pe0mgb/SI4735-Radio-ESP32-Touchscreen-Arduino/SI4732_Radio_schematics.png

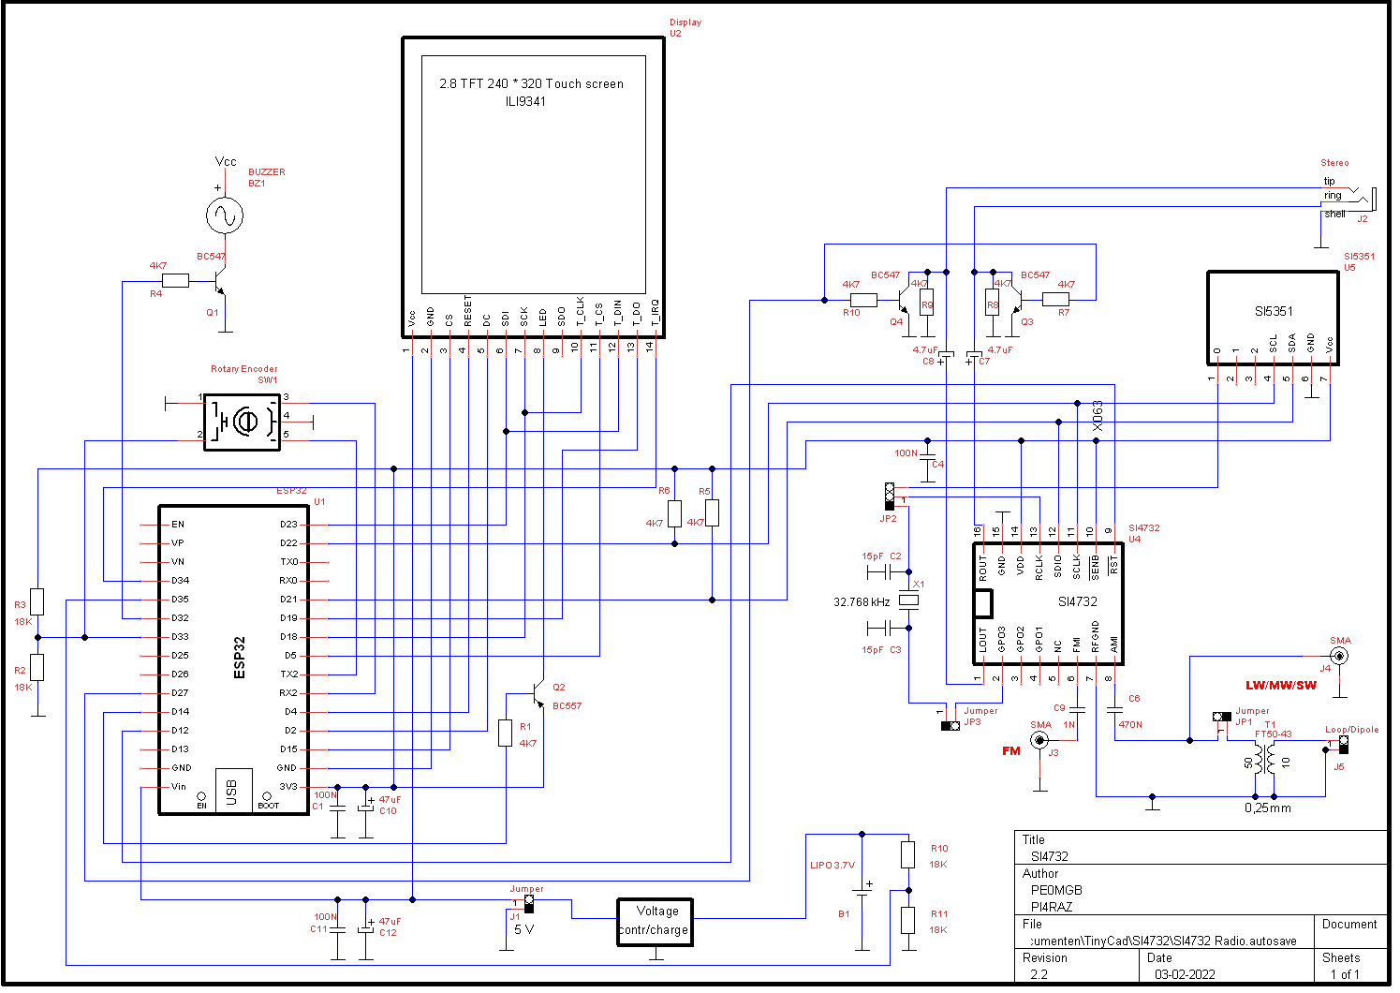
SI4732_Radio_schematics.png
