pe0mgb/SI4735-Radio-ESP32-Touchscreen-Arduino/SI4735 Radio.Receiver.png

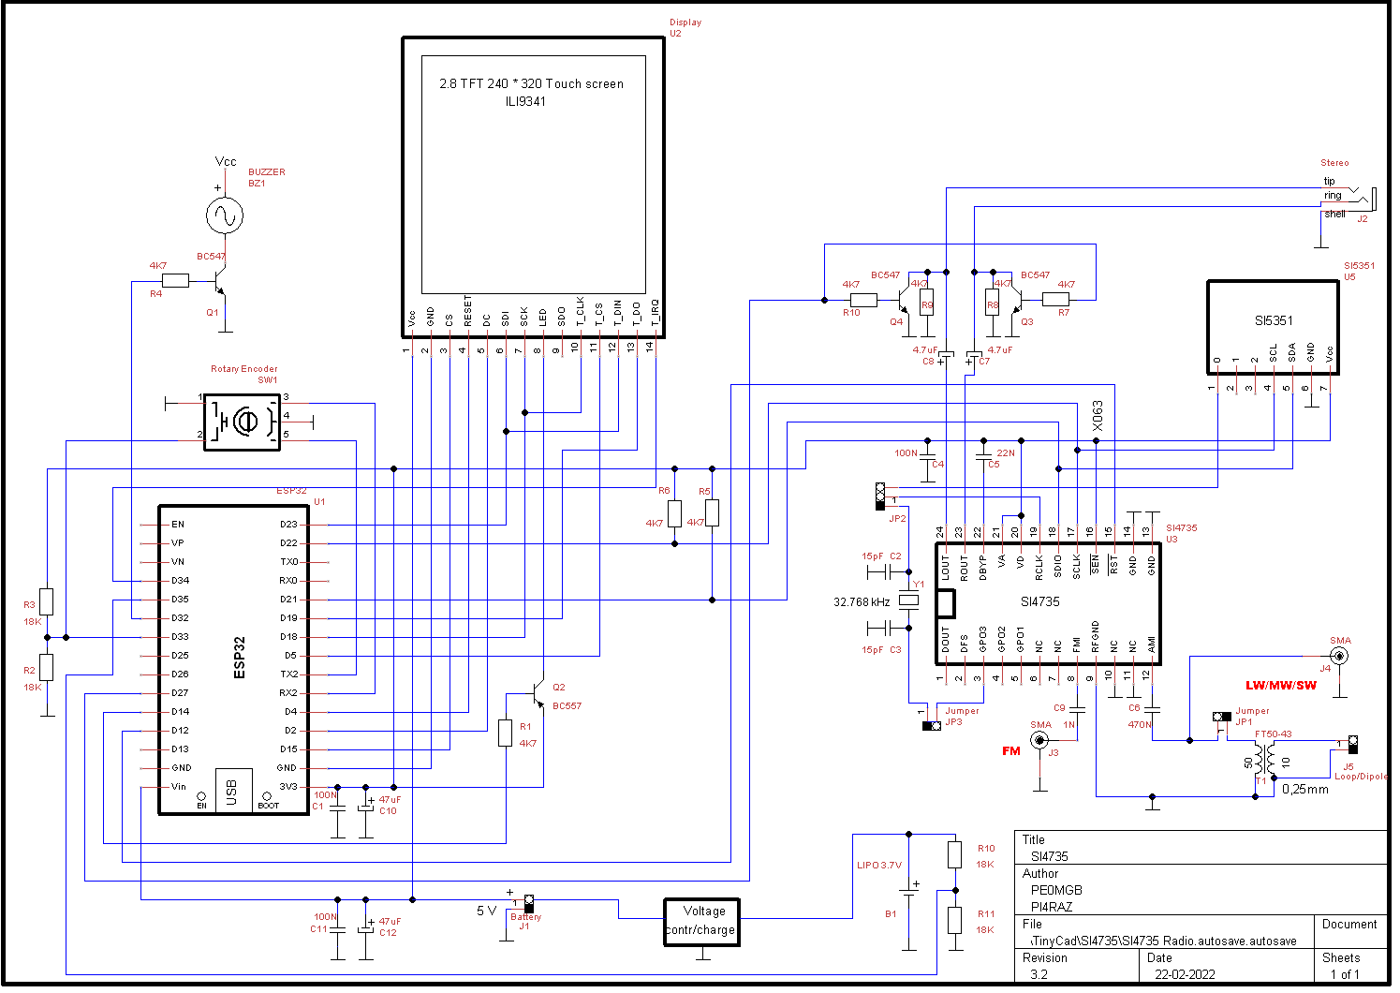
SI4735 Radio.Receiver.png
