pe0mgb/SI4735-Radio-ESP32-Touchscreen-Arduino/(threads)

Thread 1 (2020-05-28):

error

platone58, 2020-05-28:
can you help me?
i have a error compiling . this
'class SI4735' has no member named 'seekStationProgress'
but i have set libraryes and also all dependancies

pe0mgb, 2020-05-29:
Hello, I have compiled the sketch with the latest version of the library , downloaded from de si4735 github from PU2CLR Ricardo. I did not find any problem. Compilation and linking ran 100% OK. So check you library. Do have maybe the library installed twice?

Regards,

Gert PE0MGB

Van: platone58 [mailto:notifications@github.com]
Verzonden: donderdag 28 mei 2020 22:22
Aan: pe0mgb/SI4735-Radio-ESP32-Touchscreen-Arduino
CC: Subscribed
Onderwerp: [pe0mgb/SI4735-Radio-ESP32-Touchscreen-Arduino] error (#1)

can you help me?
i have a error compiling . this
'class SI4735' has no member named 'seekStationProgress'
but i have set libraryes and also all dependancies

—
You are receiving this because you are subscribed to this thread.
Reply to this email directly, view it on GitHub <https://github.com/pe0mgb/SI4735-Radio-ESP32-Touchscreen-Arduino/issues/1> , or unsubscribe <https://github.com/notifications/unsubscribe-auth/AEVBG5MHVDXWQIAYNUTA5GLRT3BXZANCNFSM4NNMX4JQ> .Afbeelding verwijderd door afzender.

--
Dit e-mailbericht is gecontroleerd op virussen met Avast antivirussoftware.
https://www.avast.com/antivirus

platone58, 2020-05-29:
I deleted and reinstalled the last library for Si4735 and the error is gone
but now I have this error:
exit status 1
Error compiling for board ESP32 Dev Module. I think my ESP32 library is not
good, which library did you use? thanks Giovanni from Italy

Il giorno ven 29 mag 2020 alle ore 12:27 Gert PE0MGB <
notifications@github.com> ha scritto:

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

platone58, 2020-05-29:
thanks , i have deleted all library and reinstalled , now work whitout error

Closed 2020-05-29.

Thread 2 (2020-05-31):

When I compile the sketch I receive error

Snowist, 2020-05-31:
I think following function needs definition before called
--------------------------------------------------------------------------------

si4735_2.8_TFT:717:16: error: expected initializer before 'RotaryEncFreq'

 void IRAM_ATTR RotaryEncFreq()

Snowist, 2020-05-31:
Solved. Wrong board selected. Currently selected ESP32 Dev board. However new compile error appeared. I have deleted other encode libraries, but this error still persist.

C:\Users\snowb\Documents\Arduino\Projeler\SI4735-Radio-ESP32-Touchscreen-Arduino-master\si4735_2.8_TFT\si4735_2.8_TFT.ino: In function 'void setup()':

si4735_2.8_TFT:779:57: error: 'RotaryEncFreq' was not declared in this scope

   attachInterrupt(digitalPinToInterrupt(ENCODER_PIN_A), RotaryEncFreq, CHANGE);

pe0mgb, 2020-05-31:
Must be wrong library. Use the supplied encoder library.

Outlook voor Android downloaden

On Sun, May 31, 2020 at 6:49 PM +0200, "Snowist" <notifications@github.com> wrote:

Solved. Wrong board selected. Currently selected ESP32 Dev board. However new compile error appeared. I have deleted other encode libraries, but this error still persist.

C:\Users\snowb\Documents\Arduino\Projeler\SI4735-Radio-ESP32-Touchscreen-Arduino-master\si4735_2.8_TFT\si4735_2.8_TFT.ino: In function 'void setup()':

si4735_2.8_TFT:779:57: error: 'RotaryEncFreq' was not declared in this scope

attachInterrupt(digitalPinToInterrupt(ENCODER_PIN_A), RotaryEncFreq, CHANGE);

—
You are receiving this because you are subscribed to this thread.
Reply to this email directly, view it on GitHub, or unsubscribe.

Snowist, 2020-06-01:
There is no other Rotary library. Just  PU2CLR_SI4735 and TFT_eSPI libs. Also tried this in VS Code Platform Tools and same error happened.

Snowist, 2020-06-01:
Found missing declaration of "RotaryEncFreq" in code and addded and created pull request.

Snowist, 2020-06-01:
I tried to add following code in my in, but just realized it is already available in .ino file here. I didn't understand why my download is missing this part of code. When I add this code worked fine.

//=======================================================================================
void IRAM_ATTR RotaryEncFreq()
//=======================================================================================
{
  // rotary encoder events
  if (!writingEeprom){
    encoderStatus = encoder.process();

    if (encoderStatus)
    {
      if (encoderStatus == DIR_CW)// Direction clockwise
      {
        encoderCount = 1;
      }
      else
      {
        encoderCount = -1;
      }
    }
  }
}

Closed 2020-06-01.

Thread 4 (2020-11-17):

HEX for ESP32 upload

Dfinitski, 2020-11-17:
Hi. I am not able to compile this project. Where can I find ready to upload HEX file ?
It would be perfect keep releases here.

pe0mgb, 2020-11-17:
David,Sorry, I have no idea how to make a hex file for the ESP32. I will try to figure it  out.Also to upload I have to check.Regards Gert PE0MGBVerzonden vanaf Samsung-tablet.
-------- Oorspronkelijk bericht --------Van: David Fainitski <notifications@github.com> Datum: 17-11-20  22:41  (GMT+01:00) Aan: pe0mgb/SI4735-Radio-ESP32-Touchscreen-Arduino <SI4735-Radio-ESP32-Touchscreen-Arduino@noreply.github.com> Cc: Subscribed <subscribed@noreply.github.com> Onderwerp: [pe0mgb/SI4735-Radio-ESP32-Touchscreen-Arduino] HEX for ESP32 upload (#4)
Hi. I am not able to compile this project. Where can I find ready to upload HEX file ?
It would be perfect keep releases here.

—You are receiving this because you are subscribed to this thread.Reply to this email directly, view it on GitHub, or unsubscribe.
[
{
"@context": "http://schema.org",
"@type": "EmailMessage",
"potentialAction": {
"@type": "ViewAction",
"target": "https://github.com/pe0mgb/SI4735-Radio-ESP32-Touchscreen-Arduino/issues/4",
"url": "https://github.com/pe0mgb/SI4735-Radio-ESP32-Touchscreen-Arduino/issues/4",
"name": "View Issue"
},
"description": "View this Issue on GitHub",
"publisher": {
"@type": "Organization",
"name": "GitHub",
"url": "https://github.com"
}
}
]

Dfinitski, 2020-11-17:
Hi. Try Sketch -> Export compiled binary

leogoto, 2020-11-17:
Hi David,

Here is hex file.

Leo/WH2Q

On Tue, 17 Nov 2020 15:36:12 -0800
David Fainitski <notifications@github.com> wrote:

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

--
Leo Gotoh <LeoGoto@yahoo.co.jp>
http://travelx.org

Dfinitski, 2020-11-18:
Hi, Leo.
Where is exactly ? Please give a link.

leogoto, 2020-11-18:
Hi David,

I do compiling.

On Tue, 17 Nov 2020 19:12:07 -0800
David Fainitski <notifications@github.com> wrote:

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

--
Leo Gotoh <LeoGoto@yahoo.co.jp>
http://travelx.org

Dfinitski, 2020-11-18:
Yes, "Export compiled binary" option creates bin file in the same directory where placed ino file.
Later everyone could upload that file into ESP32 without compilation of the project.
Sorry, initially I thought hex files format is working binary file for Arduino.
No, bin file of course.

Closed 2020-11-20.

Thread 5 (2020-11-18):

Compilation error

Dfinitski, 2020-11-18:
Hi.
I just installed latest TFT_eSPI-master and SI4735-master,

C:\SI4735-Radio-ESP32-Touchscreen-Arduino-master\si4735_2.8_TFT\si4735_2.8_TFT.ino: In function 'void setup()':
si4735_2.8_TFT:769:9: error: 'class TFT_eSPI' has no member named 'setTouch'
     tft.setTouch(calData);
         ^
C:\SI4735-Radio-ESP32-Touchscreen-Arduino-master\si4735_2.8_TFT\si4735_2.8_TFT.ino: In function 'void loop()':
si4735_2.8_TFT:1103:19: error: 'class TFT_eSPI' has no member named 'getTouch'
     pressed = tft.getTouch(&x, &y);
                   ^
C:\SI4735-Radio-ESP32-Touchscreen-Arduino-master\si4735_2.8_TFT\si4735_2.8_TFT.ino: In function 'void subrstatus()':
si4735_2.8_TFT:2296:18: error: 'class TFT_eSPI' has no member named 'getTouch'
     press1 = tft.getTouch(&x, &y);
                  ^
exit status 1
'class TFT_eSPI' has no member named 'setTouch'

pe0mgb, 2020-11-18:
Read my github , how to use tft_espiVerzonden vanaf Samsung-tablet.
-------- Oorspronkelijk bericht --------Van: David Fainitski <notifications@github.com> Datum: 18-11-20  04:38  (GMT+01:00) Aan: pe0mgb/SI4735-Radio-ESP32-Touchscreen-Arduino <SI4735-Radio-ESP32-Touchscreen-Arduino@noreply.github.com> Cc: Subscribed <subscribed@noreply.github.com> Onderwerp: [pe0mgb/SI4735-Radio-ESP32-Touchscreen-Arduino] Compilation error (#5)
Hi.
I just installed latest TFT_eSPI-master and SI4735-master,
C:\SI4735-Radio-ESP32-Touchscreen-Arduino-master\si4735_2.8_TFT\si4735_2.8_TFT.ino: In function 'void setup()':
si4735_2.8_TFT:769:9: error: 'class TFT_eSPI' has no member named 'setTouch'
tft.setTouch(calData);
^
C:\SI4735-Radio-ESP32-Touchscreen-Arduino-master\si4735_2.8_TFT\si4735_2.8_TFT.ino: In function 'void loop()':
si4735_2.8_TFT:1103:19: error: 'class TFT_eSPI' has no member named 'getTouch'
pressed = tft.getTouch(&x, &y);
^
C:\SI4735-Radio-ESP32-Touchscreen-Arduino-master\si4735_2.8_TFT\si4735_2.8_TFT.ino: In function 'void subrstatus()':
si4735_2.8_TFT:2296:18: error: 'class TFT_eSPI' has no member named 'getTouch'
press1 = tft.getTouch(&x, &y);
^
exit status 1
'class TFT_eSPI' has no member named 'setTouch'

—You are receiving this because you are subscribed to this thread.Reply to this email directly, view it on GitHub, or unsubscribe.
[
{
"@context": "http://schema.org",
"@type": "EmailMessage",
"potentialAction": {
"@type": "ViewAction",
"target": "https://github.com/pe0mgb/SI4735-Radio-ESP32-Touchscreen-Arduino/issues/5",
"url": "https://github.com/pe0mgb/SI4735-Radio-ESP32-Touchscreen-Arduino/issues/5",
"name": "View Issue"
},
"description": "View this Issue on GitHub",
"publisher": {
"@type": "Organization",
"name": "GitHub",
"url": "https://github.com"
}
}
]

Dfinitski, 2020-11-18:
Thanks for the update.
Now compilation is successful.

Closed 2020-11-18.

Thread 6 (2021-01-03):

2.8" TFT SPI 240*320

Haranochi, 2021-01-03:
I have finished building your project and it works correctly, the problem I have is that the touch screen does not work, I use a Chinese display with reference KMRTM28028-SPI, (ILI9341), I cannot find your data sheet on the Internet, can you help me to solve the problem. Thank you.

https://user-images.githubusercontent.com/76921787/103490211-8a386500-4e1a-11eb-8871-fd9760534a44.MOV

pe0mgb, 2021-01-03:
I'm afraid it is not a touchscreen. Please send me a picture of the backsite.Verzonden vanaf Samsung-tablet.
-------- Oorspronkelijk bericht --------Van: Haranochi <notifications@github.com> Datum: 03-01-21  23:22  (GMT+01:00) Aan: pe0mgb/SI4735-Radio-ESP32-Touchscreen-Arduino <SI4735-Radio-ESP32-Touchscreen-Arduino@noreply.github.com> Cc: Subscribed <subscribed@noreply.github.com> Onderwerp: [pe0mgb/SI4735-Radio-ESP32-Touchscreen-Arduino] 2.8" TFT SPI 240*320 (#6)
I have finished building your project and it works correctly, the problem I have is that the touch screen does not work, I use a Chinese display with reference KMRTM28028-SPI, (ILI9341), I cannot find your data sheet on the Internet, can you help me to solve the problem. Thank you.
https://user-images.githubusercontent.com/76921787/103490211-8a386500-4e1a-11eb-8871-fd9760534a44.MOV

—You are receiving this because you are subscribed to this thread.Reply to this email directly, view it on GitHub, or unsubscribe.
[
{
"@context": "http://schema.org",
"@type": "EmailMessage",
"potentialAction": {
"@type": "ViewAction",
"target": "https://github.com/pe0mgb/SI4735-Radio-ESP32-Touchscreen-Arduino/issues/6",
"url": "https://github.com/pe0mgb/SI4735-Radio-ESP32-Touchscreen-Arduino/issues/6",
"name": "View Issue"
},
"description": "View this Issue on GitHub",
"publisher": {
"@type": "Organization",
"name": "GitHub",
"url": "https://github.com"
}
}
]

Haranochi, 2021-01-04:
Thanks for your answer, I attach an image of the back of the display, you will see that it has an IC (HR2046), I suppose a clone of the XPT2046, ¿maybe it be defective?
In the preamble of your sketch it indicates that the display is powered by 3V3, but in your scheme the VCC of the display indicates 5V, of course it can be powered by 3V3 or 5V, your display with what voltage is it powered, in my construction I feed it with 5V If I had to feed it to 3V3, I would have to make a jumper on J1 of the display and change the supply on the pcb to 3V3. I see in the file Setup1_ILI93441.h the clock frequency of the XPT2046 is 25MHz, can it be modified to a value of 20MHz ?. The balun you use what type of copper wire you use. Thank you for your response and for making your project available to millions of people.
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

pe0mgb, 2021-01-04:
Hello Haranochi.

Thanks for the picture. What I have found on the internet that the chips are the same. Same functionality. An other story was that from your displays touch screen has different dimensions and is reverse mounted. I can not check all this information. We all know that there enough nonsense available on the Web.

Anyway I don’t know but also the layout of the TFT pcb is different as mine.  I was even not aware that other different version of the display exist.

 <https://a.aliexpress.com/_B1zwoE> https://a.aliexpress.com/_B1zwoE

This is where I have ordered my displays and a lot of other people did. Order the 2.8 TFT SPI with touch 240*320. This is with the ILI9341 and the XPT2046.

I have V1.2. Hope this will solve your problem. This Aliexpress supplier is normally very fast. !0 days here in the Netherlands.

Thanks for your remark about the 3.3 v and 5v supply of the display. I think it is better to use the 5v for the display. Then the regulator at the display is now making the 3.3v and is generating some heath .

When you supply it with 3.3v (J1)  then the esp32 regulator has to do all the work. I prefer the first proposal. I’m using 5v.

Your 25MHz or 20 MHz I don’t know how it’s working, just try it.

I’m not sure about your balun question. Are you talking about the transformer with 50 and 10 turns?. Well with the FT50-43 I use 0,2 mm or 0,25 mm. 0.3 is possible but then you may have a some spacing problem.

Best Regards,

Gert PE0MGB

Van: Haranochi [mailto:notifications@github.com]
Verzonden: maandag 4 januari 2021 12:57
Aan: pe0mgb/SI4735-Radio-ESP32-Touchscreen-Arduino
CC: Gert PE0MGB; Comment
Onderwerp: Re: [pe0mgb/SI4735-Radio-ESP32-Touchscreen-Arduino] 2.8" TFT SPI 240*320 (#6)

Thanks for your answer, I attach an image of the back of the display, you will see that it has an IC (HR2046), I suppose a clone of the XPT2046, ¿maybe it be defective?
In the preamble of your sketch it indicates that the display is powered by 3V3, but in your scheme the VCC of the display indicates 5V, of course it can be powered by 3V3 or 5V, your display with what voltage is it powered, in my construction I feed it with 5V If I had to feed it to 3V3, I would have to make a jumper on J1 of the display and change the supply on the pcb to 3V3. I see in the file Setup1_ILI93441.h the clock frequency of the XPT2046 is 25MHz, can it be modified to a value of 20MHz ?. The balun you use what type of copper wire you use. Thank you for your response and for making your project available to millions of people.
 <https://user-images.githubusercontent.com/76921787/103532779-23539400-4e8c-11eb-91e4-979a438f5ba2.jpg> Afbeelding verwijderd door afzender. IMG-4069

—
You are receiving this because you commented.
Reply to this email directly, view it on GitHub <https://github.com/pe0mgb/SI4735-Radio-ESP32-Touchscreen-Arduino/issues/6#issuecomment-753934497> , or unsubscribe <https://github.com/notifications/unsubscribe-auth/AEVBG5NNFZDK4MUKP6ANJ7DSYGUJVANCNFSM4VSHA7HA> .Afbeelding verwijderd door afzender.

--
Dit e-mailbericht is gecontroleerd op virussen met Avast antivirussoftware.
https://www.avast.com/antivirus

Haranochi, 2021-01-04:
Hi Gert,

Thanks again, another question in the Setup1_ILI9341.h file, has the following definition;

// For ESP32 Dev board (only tested with ILI9341 display)

// The hardware SPI can be mapped to any pins

#define TFT_MISO 19

#define TFT_MOSI 23

#define TFT_SCLK 18

#define TFT_CS 15 // Chip select control pin

#define TFT_DC 2 // Data Command control pin

#define TFT_RST 4 // Reset pin (could connect to RST pin)

#define TOUCH_CS 5 // Chip select pin (T_CS) of touch screen

#define TFT_MISO 19, does not connect, but Touch_DO (SPI bus out) also uses pin 19, are there problems with this configuration?

Best Regards

José María

De: Gert PE0MGB <notifications@github.com>
Enviado el: lunes, 04 de enero de 2021 15:48
Para: pe0mgb/SI4735-Radio-ESP32-Touchscreen-Arduino <SI4735-Radio-ESP32-Touchscreen-Arduino@noreply.github.com>
CC: Haranochi <haranochi@telefonica.net>; Author <author@noreply.github.com>
Asunto: Re: [pe0mgb/SI4735-Radio-ESP32-Touchscreen-Arduino] 2.8" TFT SPI 240*320 (#6)

Hello Haranochi.

Thanks for the picture. What I have found on the internet that the chips are the same. Same functionality. An other story was that from your displays touch screen has different dimensions and is reverse mounted. I can not check all this information. We all know that there enough nonsense available on the Web.

Anyway I don’t know but also the layout of the TFT pcb is different as mine. I was even not aware that other different version of the display exist.

<https://a.aliexpress.com/_B1zwoE> https://a.aliexpress.com/_B1zwoE

This is where I have ordered my displays and a lot of other people did. Order the 2.8 TFT SPI with touch 240*320. This is with the ILI9341 and the XPT2046.

I have V1.2. Hope this will solve your problem. This Aliexpress supplier is normally very fast. !0 days here in the Netherlands.

Thanks for your remark about the 3.3 v and 5v supply of the display. I think it is better to use the 5v for the display. Then the regulator at the display is now making the 3.3v and is generating some heath .

When you supply it with 3.3v (J1) then the esp32 regulator has to do all the work. I prefer the first proposal. I’m using 5v.

Your 25MHz or 20 MHz I don’t know how it’s working, just try it.

I’m not sure about your balun question. Are you talking about the transformer with 50 and 10 turns?. Well with the FT50-43 I use 0,2 mm or 0,25 mm. 0.3 is possible but then you may have a some spacing problem.

Best Regards,

Gert PE0MGB

Van: Haranochi [mailto:notifications@github.com]
Verzonden: maandag 4 januari 2021 12:57
Aan: pe0mgb/SI4735-Radio-ESP32-Touchscreen-Arduino
CC: Gert PE0MGB; Comment
Onderwerp: Re: [pe0mgb/SI4735-Radio-ESP32-Touchscreen-Arduino] 2.8" TFT SPI 240*320 (#6)

Thanks for your answer, I attach an image of the back of the display, you will see that it has an IC (HR2046), I suppose a clone of the XPT2046, ¿maybe it be defective?
In the preamble of your sketch it indicates that the display is powered by 3V3, but in your scheme the VCC of the display indicates 5V, of course it can be powered by 3V3 or 5V, your display with what voltage is it powered, in my construction I feed it with 5V If I had to feed it to 3V3, I would have to make a jumper on J1 of the display and change the supply on the pcb to 3V3. I see in the file Setup1_ILI93441.h the clock frequency of the XPT2046 is 25MHz, can it be modified to a value of 20MHz ?. The balun you use what type of copper wire you use. Thank you for your response and for making your project available to millions of people.
<https://user-images.githubusercontent.com/76921787/103532779-23539400-4e8c-11eb-91e4-979a438f5ba2.jpg> Afbeelding verwijderd door afzender. IMG-4069

—
You are receiving this because you commented.
Reply to this email directly, view it on GitHub <https://github.com/pe0mgb/SI4735-Radio-ESP32-Touchscreen-Arduino/issues/6#issuecomment-753934497> , or unsubscribe <https://github.com/notifications/unsubscribe-auth/AEVBG5NNFZDK4MUKP6ANJ7DSYGUJVANCNFSM4VSHA7HA> .Afbeelding verwijderd door afzender.

--
Dit e-mailbericht is gecontroleerd op virussen met Avast antivirussoftware.
https://www.avast.com/antivirus

—
You are receiving this because you authored the thread.
Reply to this email directly, view it on GitHub <https://github.com/pe0mgb/SI4735-Radio-ESP32-Touchscreen-Arduino/issues/6#issuecomment-754017494> , or unsubscribe <https://github.com/notifications/unsubscribe-auth/ASK3XOZKWIUWJDBJKVIM2TTSYHILFANCNFSM4VSHA7HA> .

pe0mgb, 2021-01-04:
Hello José,

Good question about D19. Pin9 or SDO is the data-out of the TFT and has to be used if you want to make a dump of a certain screen.. To save pins some screen and touch pins are connected in parallel.

The selection is done with CS (chip select) pin 3 for the TFT and T_CS (pin 11) for the touch screen. Everything is working fine with the SDO(pin9) and T_DO(pin13) in parallel. I’m also working at a 3.5 inch display that you can control  with the same hardware configuration. However the SDO (pin9) at 3.5 TFT is not tri-state. and keep pin 13(T_DO) fixed and the touch is not working. Because SDO (pin9) is not used in our application I do not connect it anymore.  Now the 2.8 and 3.5 inch TFT display are working in the same hardware configuration and can be interchanged. Be care full you still need dedicated software to control the different displays. Hope this answered your question. I’m sure this has nothing to do with your problem.

Regards,

Gert PE0MGB

Van: Haranochi [mailto:notifications@github.com]
Verzonden: maandag 4 januari 2021 18:24
Aan: pe0mgb/SI4735-Radio-ESP32-Touchscreen-Arduino
CC: Gert PE0MGB; Comment
Onderwerp: Re: [pe0mgb/SI4735-Radio-ESP32-Touchscreen-Arduino] 2.8" TFT SPI 240*320 (#6)

Hi Gert,

Thanks again, another question in the Setup1_ILI9341.h file, has the following definition;

// For ESP32 Dev board (only tested with ILI9341 display)

// The hardware SPI can be mapped to any pins

#define TFT_MISO 19

#define TFT_MOSI 23

#define TFT_SCLK 18

#define TFT_CS 15 // Chip select control pin

#define TFT_DC 2 // Data Command control pin

#define TFT_RST 4 // Reset pin (could connect to RST pin)

#define TOUCH_CS 5 // Chip select pin (T_CS) of touch screen

#define TFT_MISO 19, does not connect, but Touch_DO (SPI bus out) also uses pin 19, are there problems with this configuration?

Best Regards

José María

De: Gert PE0MGB <notifications@github.com>
Enviado el: lunes, 04 de enero de 2021 15:48
Para: pe0mgb/SI4735-Radio-ESP32-Touchscreen-Arduino <SI4735-Radio-ESP32-Touchscreen-Arduino@noreply.github.com>
CC: Haranochi <haranochi@telefonica.net>; Author <author@noreply.github.com>
Asunto: Re: [pe0mgb/SI4735-Radio-ESP32-Touchscreen-Arduino] 2.8" TFT SPI 240*320 (#6)

Hello Haranochi.

Thanks for the picture. What I have found on the internet that the chips are the same. Same functionality. An other story was that from your displays touch screen has different dimensions and is reverse mounted. I can not check all this information. We all know that there enough nonsense available on the Web.

Anyway I don’t know but also the layout of the TFT pcb is different as mine. I was even not aware that other different version of the display exist.

<https://a.aliexpress.com/_B1zwoE> https://a.aliexpress.com/_B1zwoE

This is where I have ordered my displays and a lot of other people did. Order the 2.8 TFT SPI with touch 240*320. This is with the ILI9341 and the XPT2046.

I have V1.2. Hope this will solve your problem. This Aliexpress supplier is normally very fast. !0 days here in the Netherlands.

Thanks for your remark about the 3.3 v and 5v supply of the display. I think it is better to use the 5v for the display. Then the regulator at the display is now making the 3.3v and is generating some heath .

When you supply it with 3.3v (J1) then the esp32 regulator has to do all the work. I prefer the first proposal. I’m using 5v.

Your 25MHz or 20 MHz I don’t know how it’s working, just try it.

I’m not sure about your balun question. Are you talking about the transformer with 50 and 10 turns?. Well with the FT50-43 I use 0,2 mm or 0,25 mm. 0.3 is possible but then you may have a some spacing problem.

Best Regards,

Gert PE0MGB

Van: Haranochi [mailto:notifications@github.com]
Verzonden: maandag 4 januari 2021 12:57
Aan: pe0mgb/SI4735-Radio-ESP32-Touchscreen-Arduino
CC: Gert PE0MGB; Comment
Onderwerp: Re: [pe0mgb/SI4735-Radio-ESP32-Touchscreen-Arduino] 2.8" TFT SPI 240*320 (#6)

Thanks for your answer, I attach an image of the back of the display, you will see that it has an IC (HR2046), I suppose a clone of the XPT2046, ¿maybe it be defective?
In the preamble of your sketch it indicates that the display is powered by 3V3, but in your scheme the VCC of the display indicates 5V, of course it can be powered by 3V3 or 5V, your display with what voltage is it powered, in my construction I feed it with 5V If I had to feed it to 3V3, I would have to make a jumper on J1 of the display and change the supply on the pcb to 3V3. I see in the file Setup1_ILI93441.h the clock frequency of the XPT2046 is 25MHz, can it be modified to a value of 20MHz ?. The balun you use what type of copper wire you use. Thank you for your response and for making your project available to millions of people.
<https://user-images.githubusercontent.com/76921787/103532779-23539400-4e8c-11eb-91e4-979a438f5ba2.jpg> Afbeelding verwijderd door afzender. IMG-4069

—
You are receiving this because you commented.
Reply to this email directly, view it on GitHub <https://github.com/pe0mgb/SI4735-Radio-ESP32-Touchscreen-Arduino/issues/6#issuecomment-753934497> , or unsubscribe <https://github.com/notifications/unsubscribe-auth/AEVBG5NNFZDK4MUKP6ANJ7DSYGUJVANCNFSM4VSHA7HA> .Afbeelding verwijderd door afzender.

--
Dit e-mailbericht is gecontroleerd op virussen met Avast antivirussoftware.
https://www.avast.com/antivirus

—
You are receiving this because you authored the thread.
Reply to this email directly, view it on GitHub <https://github.com/pe0mgb/SI4735-Radio-ESP32-Touchscreen-Arduino/issues/6#issuecomment-754017494> , or unsubscribe <https://github.com/notifications/unsubscribe-auth/ASK3XOZKWIUWJDBJKVIM2TTSYHILFANCNFSM4VSHA7HA> .

—
You are receiving this because you commented.
Reply to this email directly, view it on GitHub <https://github.com/pe0mgb/SI4735-Radio-ESP32-Touchscreen-Arduino/issues/6#issuecomment-754105907> , or unsubscribe <https://github.com/notifications/unsubscribe-auth/AEVBG5PGRCL7AFZBLNQCN73SYH2UVANCNFSM4VSHA7HA> .Afbeelding verwijderd door afzender.

Haranochi, 2021-01-04:
Gert, good night

No, it is not related to my problem, curiosity to know the use of D19, thanks for the explanation, researching I have seen that pin 14 (T_IRQ) is always at high level and when it touched any menu on the screen it falls to low, this is correct, it detects a pressed menu key, now my question is about pin 11 (T_CS), it is high or low, in my case it is always high, it does not change, and I think it must be low to enable chip select signal. If you have time, you can explain to me the operation of the T_IRQ and T_CS pins. The Chinese display works with the Touch_calibrate example from the TFT_eSPI library, connecting it as indicated by the creator of the library, bodmer.

Regards

José María

De: Gert PE0MGB <notifications@github.com>
Enviado el: lunes, 04 de enero de 2021 19:58
Para: pe0mgb/SI4735-Radio-ESP32-Touchscreen-Arduino <SI4735-Radio-ESP32-Touchscreen-Arduino@noreply.github.com>
CC: Haranochi <haranochi@telefonica.net>; Author <author@noreply.github.com>
Asunto: Re: [pe0mgb/SI4735-Radio-ESP32-Touchscreen-Arduino] 2.8" TFT SPI 240*320 (#6)

Hello José,

Good question about D19. Pin9 or SDO is the data-out of the TFT and has to be used if you want to make a dump of a certain screen.. To save pins some screen and touch pins are connected in parallel.

The selection is done with CS (chip select) pin 3 for the TFT and T_CS (pin 11) for the touch screen. Everything is working fine with the SDO(pin9) and T_DO(pin13) in parallel. I’m also working at a 3.5 inch display that you can control with the same hardware configuration. However the SDO (pin9) at 3.5 TFT is not tri-state. and keep pin 13(T_DO) fixed and the touch is not working. Because SDO (pin9) is not used in our application I do not connect it anymore. Now the 2.8 and 3.5 inch TFT display are working in the same hardware configuration and can be interchanged. Be care full you still need dedicated software to control the different displays. Hope this answered your question. I’m sure this has nothing to do with your problem.

Regards,

Gert PE0MGB

Van: Haranochi [mailto:notifications@github.com]
Verzonden: maandag 4 januari 2021 18:24
Aan: pe0mgb/SI4735-Radio-ESP32-Touchscreen-Arduino
CC: Gert PE0MGB; Comment
Onderwerp: Re: [pe0mgb/SI4735-Radio-ESP32-Touchscreen-Arduino] 2.8" TFT SPI 240*320 (#6)

Hi Gert,

Thanks again, another question in the Setup1_ILI9341.h file, has the following definition;

// For ESP32 Dev board (only tested with ILI9341 display)

// The hardware SPI can be mapped to any pins

#define TFT_MISO 19

#define TFT_MOSI 23

#define TFT_SCLK 18

#define TFT_CS 15 // Chip select control pin

#define TFT_DC 2 // Data Command control pin

#define TFT_RST 4 // Reset pin (could connect to RST pin)

#define TOUCH_CS 5 // Chip select pin (T_CS) of touch screen

#define TFT_MISO 19, does not connect, but Touch_DO (SPI bus out) also uses pin 19, are there problems with this configuration?

Best Regards

José María

De: Gert PE0MGB <notifications@github.com>
Enviado el: lunes, 04 de enero de 2021 15:48
Para: pe0mgb/SI4735-Radio-ESP32-Touchscreen-Arduino <SI4735-Radio-ESP32-Touchscreen-Arduino@noreply.github.com>
CC: Haranochi <haranochi@telefonica.net>; Author <author@noreply.github.com>
Asunto: Re: [pe0mgb/SI4735-Radio-ESP32-Touchscreen-Arduino] 2.8" TFT SPI 240*320 (#6)

Hello Haranochi.

Thanks for the picture. What I have found on the internet that the chips are the same. Same functionality. An other story was that from your displays touch screen has different dimensions and is reverse mounted. I can not check all this information. We all know that there enough nonsense available on the Web.

Anyway I don’t know but also the layout of the TFT pcb is different as mine. I was even not aware that other different version of the display exist.

<https://a.aliexpress.com/_B1zwoE> https://a.aliexpress.com/_B1zwoE

This is where I have ordered my displays and a lot of other people did. Order the 2.8 TFT SPI with touch 240*320. This is with the ILI9341 and the XPT2046.

I have V1.2. Hope this will solve your problem. This Aliexpress supplier is normally very fast. !0 days here in the Netherlands.

Thanks for your remark about the 3.3 v and 5v supply of the display. I think it is better to use the 5v for the display. Then the regulator at the display is now making the 3.3v and is generating some heath .

When you supply it with 3.3v (J1) then the esp32 regulator has to do all the work. I prefer the first proposal. I’m using 5v.

Your 25MHz or 20 MHz I don’t know how it’s working, just try it.

I’m not sure about your balun question. Are you talking about the transformer with 50 and 10 turns?. Well with the FT50-43 I use 0,2 mm or 0,25 mm. 0.3 is possible but then you may have a some spacing problem.

Best Regards,

Gert PE0MGB

Van: Haranochi [mailto:notifications@github.com]
Verzonden: maandag 4 januari 2021 12:57
Aan: pe0mgb/SI4735-Radio-ESP32-Touchscreen-Arduino
CC: Gert PE0MGB; Comment
Onderwerp: Re: [pe0mgb/SI4735-Radio-ESP32-Touchscreen-Arduino] 2.8" TFT SPI 240*320 (#6)

Thanks for your answer, I attach an image of the back of the display, you will see that it has an IC (HR2046), I suppose a clone of the XPT2046, ¿maybe it be defective?
In the preamble of your sketch it indicates that the display is powered by 3V3, but in your scheme the VCC of the display indicates 5V, of course it can be powered by 3V3 or 5V, your display with what voltage is it powered, in my construction I feed it with 5V If I had to feed it to 3V3, I would have to make a jumper on J1 of the display and change the supply on the pcb to 3V3. I see in the file Setup1_ILI93441.h the clock frequency of the XPT2046 is 25MHz, can it be modified to a value of 20MHz ?. The balun you use what type of copper wire you use. Thank you for your response and for making your project available to millions of people.
<https://user-images.githubusercontent.com/76921787/103532779-23539400-4e8c-11eb-91e4-979a438f5ba2.jpg> Afbeelding verwijderd door afzender. IMG-4069

—
You are receiving this because you commented.
Reply to this email directly, view it on GitHub <https://github.com/pe0mgb/SI4735-Radio-ESP32-Touchscreen-Arduino/issues/6#issuecomment-753934497> , or unsubscribe <https://github.com/notifications/unsubscribe-auth/AEVBG5NNFZDK4MUKP6ANJ7DSYGUJVANCNFSM4VSHA7HA> .Afbeelding verwijderd door afzender.

--
Dit e-mailbericht is gecontroleerd op virussen met Avast antivirussoftware.
https://www.avast.com/antivirus

—
You are receiving this because you authored the thread.
Reply to this email directly, view it on GitHub <https://github.com/pe0mgb/SI4735-Radio-ESP32-Touchscreen-Arduino/issues/6#issuecomment-754017494> , or unsubscribe <https://github.com/notifications/unsubscribe-auth/ASK3XOZKWIUWJDBJKVIM2TTSYHILFANCNFSM4VSHA7HA> .

—
You are receiving this because you commented.
Reply to this email directly, view it on GitHub <https://github.com/pe0mgb/SI4735-Radio-ESP32-Touchscreen-Arduino/issues/6#issuecomment-754105907> , or unsubscribe <https://github.com/notifications/unsubscribe-auth/AEVBG5PGRCL7AFZBLNQCN73SYH2UVANCNFSM4VSHA7HA> .Afbeelding verwijderd door afzender.

—
You are receiving this because you authored the thread.
Reply to this email directly, view it on GitHub <https://github.com/pe0mgb/SI4735-Radio-ESP32-Touchscreen-Arduino/issues/6#issuecomment-754153841> , or unsubscribe <https://github.com/notifications/unsubscribe-auth/ASK3XO3POANDOB2NCH6FT33SYIFUNANCNFSM4VSHA7HA> .

pe0mgb, 2021-01-05:
José,

I understand that the calibration program is running and you can calibrate the TFT. That means that everything works. You can run the program on the radio without any change in files. Just download the calibration-program. Don’t forget the rotation. When the program works try to replace the calibration data in my program with the generated data by yourself. You can find this information at the beginning of the setup routine. When the program is not working, please check the display wiring.

Please let me know about the results.

Gert

Van: Haranochi [mailto:notifications@github.com]
Verzonden: maandag 4 januari 2021 22:49
Aan: pe0mgb/SI4735-Radio-ESP32-Touchscreen-Arduino
CC: Gert PE0MGB; Comment
Onderwerp: Re: [pe0mgb/SI4735-Radio-ESP32-Touchscreen-Arduino] 2.8" TFT SPI 240*320 (#6)

Gert, good night

No, it is not related to my problem, curiosity to know the use of D19, thanks for the explanation, researching I have seen that pin 14 (T_IRQ) is always at high level and when it touched any menu on the screen it falls to low, this is correct, it detects a pressed menu key, now my question is about pin 11 (T_CS), it is high or low, in my case it is always high, it does not change, and I think it must be low to enable chip select signal. If you have time, you can explain to me the operation of the T_IRQ and T_CS pins. The Chinese display works with the Touch_calibrate example from the TFT_eSPI library, connecting it as indicated by the creator of the library, bodmer.

Regards

José María

De: Gert PE0MGB <notifications@github.com>
Enviado el: lunes, 04 de enero de 2021 19:58
Para: pe0mgb/SI4735-Radio-ESP32-Touchscreen-Arduino <SI4735-Radio-ESP32-Touchscreen-Arduino@noreply.github.com>
CC: Haranochi <haranochi@telefonica.net>; Author <author@noreply.github.com>
Asunto: Re: [pe0mgb/SI4735-Radio-ESP32-Touchscreen-Arduino] 2.8" TFT SPI 240*320 (#6)

Hello José,

Good question about D19. Pin9 or SDO is the data-out of the TFT and has to be used if you want to make a dump of a certain screen.. To save pins some screen and touch pins are connected in parallel.

The selection is done with CS (chip select) pin 3 for the TFT and T_CS (pin 11) for the touch screen. Everything is working fine with the SDO(pin9) and T_DO(pin13) in parallel. I’m also working at a 3.5 inch display that you can control with the same hardware configuration. However the SDO (pin9) at 3.5 TFT is not tri-state. and keep pin 13(T_DO) fixed and the touch is not working. Because SDO (pin9) is not used in our application I do not connect it anymore. Now the 2.8 and 3.5 inch TFT display are working in the same hardware configuration and can be interchanged. Be care full you still need dedicated software to control the different displays. Hope this answered your question. I’m sure this has nothing to do with your problem.

Regards,

Gert PE0MGB

Van: Haranochi [mailto:notifications@github.com]
Verzonden: maandag 4 januari 2021 18:24
Aan: pe0mgb/SI4735-Radio-ESP32-Touchscreen-Arduino
CC: Gert PE0MGB; Comment
Onderwerp: Re: [pe0mgb/SI4735-Radio-ESP32-Touchscreen-Arduino] 2.8" TFT SPI 240*320 (#6)

Hi Gert,

Thanks again, another question in the Setup1_ILI9341.h file, has the following definition;

// For ESP32 Dev board (only tested with ILI9341 display)

// The hardware SPI can be mapped to any pins

#define TFT_MISO 19

#define TFT_MOSI 23

#define TFT_SCLK 18

#define TFT_CS 15 // Chip select control pin

#define TFT_DC 2 // Data Command control pin

#define TFT_RST 4 // Reset pin (could connect to RST pin)

#define TOUCH_CS 5 // Chip select pin (T_CS) of touch screen

#define TFT_MISO 19, does not connect, but Touch_DO (SPI bus out) also uses pin 19, are there problems with this configuration?

Best Regards

José María

De: Gert PE0MGB <notifications@github.com>
Enviado el: lunes, 04 de enero de 2021 15:48
Para: pe0mgb/SI4735-Radio-ESP32-Touchscreen-Arduino <SI4735-Radio-ESP32-Touchscreen-Arduino@noreply.github.com>
CC: Haranochi <haranochi@telefonica.net>; Author <author@noreply.github.com>
Asunto: Re: [pe0mgb/SI4735-Radio-ESP32-Touchscreen-Arduino] 2.8" TFT SPI 240*320 (#6)

Hello Haranochi.

Thanks for the picture. What I have found on the internet that the chips are the same. Same functionality. An other story was that from your displays touch screen has different dimensions and is reverse mounted. I can not check all this information. We all know that there enough nonsense available on the Web.

Anyway I don’t know but also the layout of the TFT pcb is different as mine. I was even not aware that other different version of the display exist.

<https://a.aliexpress.com/_B1zwoE> https://a.aliexpress.com/_B1zwoE

This is where I have ordered my displays and a lot of other people did. Order the 2.8 TFT SPI with touch 240*320. This is with the ILI9341 and the XPT2046.

I have V1.2. Hope this will solve your problem. This Aliexpress supplier is normally very fast. !0 days here in the Netherlands.

Thanks for your remark about the 3.3 v and 5v supply of the display. I think it is better to use the 5v for the display. Then the regulator at the display is now making the 3.3v and is generating some heath .

When you supply it with 3.3v (J1) then the esp32 regulator has to do all the work. I prefer the first proposal. I’m using 5v.

Your 25MHz or 20 MHz I don’t know how it’s working, just try it.

I’m not sure about your balun question. Are you talking about the transformer with 50 and 10 turns?. Well with the FT50-43 I use 0,2 mm or 0,25 mm. 0.3 is possible but then you may have a some spacing problem.

Best Regards,

Gert PE0MGB

Van: Haranochi
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

Thread 7 (2021-04-26):

Touch calibration

codeput, 2021-04-26:
I have problems with entering frequencies directly, the touch is not perfectly centered, is it possible to draw the keyboard slightly to the right?

pe0mgb, 2021-04-26:
Hello,

Normally with a 2.8 inch display I have never seen a problem. I think you are using a screen with another size. What will help is calibrating the screen.

In the TFT_eSPI library in examples/Generic there is a calibration program called Touch calibrate. Here you can calibrate the display. Think about the rotation !!! This is very important.

The found figures you have to fill in in  the setup part of my sketch. See line 774 and 780

I have never checked the sketch with an other display . But I think it is possible the give an offset. I will check it the coming days. But it will work only for the main screen.

Let me know if it works or not..

Regards,

Gert PE0MGB

Van: codeput ***@***.***
Verzonden: maandag 26 april 2021 13:05
Aan: pe0mgb/SI4735-Radio-ESP32-Touchscreen-Arduino
CC: Subscribed
Onderwerp: [pe0mgb/SI4735-Radio-ESP32-Touchscreen-Arduino] Touch calibration (#7)

I have problems with entering frequencies directly, the touch is not perfectly centered, is it possible to draw the keyboard slightly to the right?

—
You are receiving this because you are subscribed to this thread.
Reply to this email directly, view it on GitHub <https://github.com/pe0mgb/SI4735-Radio-ESP32-Touchscreen-Arduino/issues/7> , or unsubscribe <https://github.com/notifications/unsubscribe-auth/AEVBG5I5263X46EG6ZBHR5DTKVCF5ANCNFSM43SU2HCQ> .  <https://github.com/notifications/beacon/AEVBG5PE6MNWTCIWZGMLOTDTKVCF5A5CNFSM43SU2HC2YY3PNVWWK3TUL52HS4DFUVEXG43VMWVGG33NNVSW45C7NFSM4M5WHCVA.gif>

--
Dit e-mailbericht is gecontroleerd op virussen met Avast antivirussoftware.
https://www.avast.com/antivirus

codeput, 2021-04-26:
You are right, my display is 2.4 inches so it is not possible to correct
the position of the touch?

Il lun 26 apr 2021, 15:59 Gert PE0MGB ***@***.***> ha scritto:

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

pe0mgb, 2021-04-26:
No, the program is written for 2.8 inch. With 2.4 of course it is posible. You only have to rewrite a part of the programma. Forget it. Buy a 2.8 and your problemen are solved.

⁣BlueMail voor Android downloaden

Op 26 apr. 2021 17:23, om 17:23, codeput ***@***.***> schreef:
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

pe0mgb, 2021-04-27:
When your 2.4 tft had 240*320 pickels Just calibrate and it will work the same as a 2.8

⁣BlueMail voor Android downloaden

Op 26 apr. 2021 17:23, om 17:23, codeput ***@***.***> schreef:
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

codeput, 2021-04-27:
Thanks a lot Gert, I solved it using the bookmark utility in the
library. Now it works perfectly.

Il giorno mar 27 apr 2021 alle ore 07:45 Gert PE0MGB <
***@***.***> ha scritto:

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

codeput, 2021-04-27:
Thanks a lot Gert, I solved it using the calibration utility in the
library. Now it works perfectly.

Il giorno mar 27 apr 2021 alle ore 07:50 Emanuele Principi <
***@***.***> ha scritto:

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

yo2ldk, 2021-04-27:
Hi Gert,
  when I  touch the broad band, input freq I can see that window, then my display frozen and need to reset
  work fine in FM start.
  please any tips / advice

   best regards,

      de yo2ldk - alexander

pe0mgb, 2021-04-27:
Hello Alexander,
It looks like the program stopped. No Idea what happen. I have no experience with the Wemos device. It looks like the problem is there. I use always the 30 pin ESP32. I realize this is a bad answer but I really don't know and I can not simulate the problem. If posible try a 30 pin ESP32 and it will work.

Regards,
Gert PE0MGB

⁣BlueMail voor Android downloaden

Op 27 apr. 2021 09:20, om 09:20, alexander - yo2ldk ***@***.***> schreef:
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

yo2ldk, 2021-04-27:
Thank you Gert a lot, for your answer and  your version for SI4735.
the rotary knob also running in a very strage way some time good, sometime after 3-5 rotations,
so, I change the pinouts of the encoder to D25 and D25, sw to D39, and now the radio is ALIVE!  :)
 I cannot explain what it was, but I'm happy with him running..

   all the best and 73,

    yo2ldk -alexander
    TNX AGN !

Closed 2021-04-29.

Thread 8 (2021-04-29):

Volume and noise

codeput, 2021-04-29:
I realized that the volume, even if set to zero, does not go down completely and in MW the noise is very high and covers weak signals.

pe0mgb, 2021-04-29:
Noise is probably coming from the powersupply. Never use a switchmode psu. Check out with a battery or a real analoge psu.
If you want to change the volume at the lowest level, check Line 1138 in my sketch.
In vol=map(vol,20,63 etc you can change 20 tot 0 and the radio is really quite. I use the mute for that.

Gert PE0MGB

⁣BlueMail voor Android downloaden

Op 29 apr. 2021 06:51, om 06:51, codeput ***@***.***> schreef:
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

Thread 11 (2021-11-18):

display does not dim or turn off after 5min

larrykabo, 2021-11-18:
This is stated in v 3.3 release notes

pe0mgb, 2021-11-18:
Are you using an ATS25?
BlueMail <https://bluemail.me> for Desktopdownloaden
larrykabo wrote:
This is stated in v 3.3 release notes
—
You are receiving this because you are subscribed to this thread.
Reply to this email directly, view it on GitHub <https://github.com/pe0mgb/SI4735-Radio-ESP32-Touchscreen-Arduino/issues/11> , or unsubscribe <https://github.com/notifications/unsubscribe-auth/AEVBG5LN7WUO7HNJYTELPQDUMVZMBANCNFSM5IKWG3GQ> .
Triage notifications on the go with GitHub Mobile for iOS <https://apps.apple.com/app/apple-store/id1477376905?ct=notification-email&mt=8&pt=524675> or Android <https://play.google.com/store/apps/details?id=com.github.android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> .

larrykabo, 2021-11-18:
yes, ats25

On Thu, Nov 18, 2021 at 5:13 PM Gert PE0MGB ***@***.***>
wrote:

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

pe0mgb, 2021-11-18:
Larry,
The problem is that the ATS-25 is for 99% a copy of my hardware and software design. All my software is developed for my developed hardware and is copied by some people . To the best of my knowledge there are in the ATS25 design 3 transistors missing. No idea why. Maybe cheaper. One of the transistors is able to switch off or dim the backlight of the TFT. That works in my hardware. Unfortunately in the ATS25 the transistor is missing. The other two transistors are used to switch off the LF during bandswitching because of a very nasty click in LF. In the ATS25 it is loud present.
I have never build a SI5351 in an ATS25 .Way to difficult with all the small tracks and SMD components. I'm still trying to get the important software parts up and running in the ATS25 but don't blame me when it is not working. I have spend a lot of time with testing the ATS25. With a good antenne it works very well. Do not expect miracles from a rod-antenna at the backsite. First of all there is some distorsion from the radio. ESP32 controller and the TFT screen are causing a lot of noise. I have found that the aluminum box is not grounded. You can do that simple with a connection with a piece of wire from the ground of the antenna connector and two bolt connected to the upper and lower part of the housing. This reduced the noise already at lot but it is not gone.
An wire antenne, I prefer a dipole, give you an excelent signal from many station. I'm still impressed about the performance of SI4732 or SI4735 radio chip using the library developed by Ricardo PU2CLR. Without that library my radio didn't excist. Hope that this clears a little bit the situation.
Regards,
Gert PE0MGB
BlueMail <https://bluemail.me> for Desktopdownloaden
larrykabo wrote:
yes, ats25
On Thu, Nov 18, 2021 at 5:13 PM Gert PE0MGB ***@***.***>
wrote:
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
—
You are receiving this because you commented.
Reply to this email directly, view it on GitHub <https://github.com/pe0mgb/SI4735-Radio-ESP32-Touchscreen-Arduino/issues/11#issuecomment-973356287> , or unsubscribe <https://github.com/notifications/unsubscribe-auth/AEVBG5L3T525RDEIPQRMYLLUMV7LLANCNFSM5IKWG3GQ> .
Triage notifications on the go with GitHub Mobile for iOS <https://apps.apple.com/app/apple-store/id1477376905?ct=notification-email&mt=8&pt=524675> or Android <https://play.google.com/store/apps/details?id=com.github.android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> .

larrykabo, 2021-11-19:
Thanks for your patience and great explanation, do you know what the
missing chip on the back of display board might be for?

Larry

On Thu, Nov 18, 2021 at 6:53 PM Gert PE0MGB ***@***.***>
wrote:

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

larrykabo, 2021-11-19:
Also, the two halves of the ATS25 will not ground together, that anodized
aluminum needs some grinding/sanding to complete the whole shell ground,
but stuffs going to leak in the front and back.

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

Thread 9 (2021-11-18):

changes for clock schematic is not on github

larrykabo, 2021-11-18:
Not only that it defaults to the hardware modified version, most people like me took time to figure this out. 2nd where are the hardware things I need to do to use the improved option?

pe0mgb, 2021-11-18:
I'm not sure if I understand your question. But how to connect the SI5351 is in my schematics. When stay at the crystal you don't need any additional hardware. For the ATS-25 as I told you, only the display dimmer is not working due to a missing
transistor.
⁣BlueMail voor Android downloaden

Op 18 nov. 2021 16:45, om 16:45, larrykabo ***@***.***> schreef:
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

larrykabo, 2021-11-18:
is it possible for you to provide pics of the si5351 mods? the
schematics included with that release show jumpers etc of certain ones need
to be changed, no jumpers on the board to be moved and the schematic does
not show all the chip in the unit across the 2 boards yet there are chip in
the schematic that are located on 2 different boards, like the usb
interface is nowhere in the schematics. is there another full schematic?.
On the front board there is a missing chip, is this where the si5351 goes?

On Thu, Nov 18, 2021 at 12:07 PM Gert PE0MGB ***@***.***>
wrote:

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

Thread 14 (2022-01-29):

AGC enables in SSB after tuning so far

madmax2069, 2022-01-29:
I'm using an ATS-25 running 3.4

When in SSB and I manually turn AGC off when you tune so far (like 15KHz) you'll hear a chuff sound and the AGC will be enabled but the button isn't highlighted like it's off.

When you press the AGC button it'll turn the AGC back off and the button will stay un-highlighted to match the AGC being off. But you tune so far again it'll make that chuff sound and the AGC will be enabled itself again with the button showing that it's off.

pe0mgb, 2022-01-30:
Hi MadMax,

Thanks for all the comments.

1) The medium wave. That's a problem with all the different band plans in the world. It's not just on medium wave. There are also worldwide differences in the Hambands. I will create a separate band format for the North American region that you can select with a #define to run the compiler. To ease the suffering now you can easily make a change for the MW manually.

In version 3.4 you will find in the following line:

661 { "MW", MW_BAND_TYPE, AM, 522, 1701, 1395, 9, 0, 0}, // MW 2

Change it as below. This is the North American band plan. 1390 means 1390 KHz and is a preferred frequency that the program starts at the first time.

661 { "MW", MW_BAND_TYPE, AM, 530, 1700, 1390, 10, 0, 0}, // MW 2

2) Sorry but I don't understand this question.

3) The next comment was about the behavior of the radio with the BFO frequency and the secretive changing of the frequency. You are absolutely right. That's a really nasty bug. This will be fixed in my next release.

4) Your comment about the AGC turning back on with a frequency change is a known old problem. The cause here is in the software patch that is always loaded for SSB. No source is available, but it does contain SSB's secret for this chip. You may be able to create a bypass in the library, but that has not been implemented so far. I'll pay attention to it again. One consolation is that SSB works best with the AGC on.

I'll keep you posted on the progress.

Best Regards,

Gert PE0MGB

Van: madmax2069 ***@***.***>
Verzonden: zaterdag 29 januari 2022 17:04
Aan: pe0mgb/SI4735-Radio-ESP32-Touchscreen-Arduino ***@***.***>
CC: Subscribed ***@***.***>
Onderwerp: [pe0mgb/SI4735-Radio-ESP32-Touchscreen-Arduino] AGC enables in SSB after tuning so far (Issue #14)

I'm using an ATS-25 running 3.4

When in SSB and I manually turn AGC off when you tune so far (like 15KHz) you'll hear a chuff sound and the AGC will be enabled but the button isn't highlighted like it's off.

When you press the AGC button it'll turn the AGC back off and the button will stay un-highlighted to match the AGC being off. But you tune so far again it'll make that chuff sound and the AGC will be enabled itself again with the button showing that it's off.

—
Reply to this email directly, view it on GitHub <https://github.com/pe0mgb/SI4735-Radio-ESP32-Touchscreen-Arduino/issues/14> , or unsubscribe <https://github.com/notifications/unsubscribe-auth/AEVBG5MIFCREZONHH4OUH6DUYQFYVANCNFSM5NDBT35A> .
Triage notifications on the go with GitHub Mobile for iOS <https://apps.apple.com/app/apple-store/id1477376905?ct=notification-email&mt=8&pt=524675>  or Android <https://play.google.com/store/apps/details?id=com.github.android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> .
You are receiving this because you are subscribed to this thread.  <https://github.com/notifications/beacon/AEVBG5JVG54RSLB5DIW7EFLUYQFYVA5CNFSM5NDBT35KYY3PNVWWK3TUL52HS4DFUVEXG43VMWVGG33NNVSW45C7NFSM4QVHHTUA.gif> Message ID: ***@***.*** ***@***.***> >

madmax2069, 2022-01-31:
Hello, thanks for the quick reply

 I just tried making the edit for the MW/AM frequencies and during compile process I get an error

Fatal error: Rotary.h: no such file or directory, so I take it I'm missing a library ? If I am what library do I need to install ?

pe0mgb, 2022-01-31:
You can find the library at my github
Outlook voor Android downloaden

madmax2069, 2022-02-01:
I figured it out (pulled the files I needed from the .zip I downloaded from here), made the change to the MW frequency range and pushed the change to the radio. The only thing I touched in the sketch is what you told me to change for the MW frequency range.

But now AGC isn't working correctly like how it use to work before the change, AGC isn't recovering when changing the frequency.

When I turn the radio on now (AGC is on by default which is normal) but regardless of where I had the volume set (I could have the volume set to 50) the sound is really low (like the volume is around 5). When I disable AGC the the sound loudness returns to normal. And when I enable the AGC after turning AGC off the sound is just as loud as with AGC off. BUT as soon as I turn the channel/Frequency with AGC on the sound loudness drops really low again and doesn't recover like it use to do, before when AGC was enabled and I changed the frequency there would be a temporary drop in sound loudness and would slowly recover back to a normal loudness.

I'm probably going to have to make a video showing you what I'm talking about as I'm not the best explaining things.

madmax2069, 2022-02-01:
Here's a video of what I'm talking about. https://youtu.be/nIRpz8nPmw0

Thread 15 (2022-02-20):

compiling V3.0-3.4 with IDE1.8.15 not succesfull

hamroel, 2022-02-20:
compiling version 3.0 - 3.4  gives a bunch of errors for all versions:

in IDE opened the ino + rotary.cpp + rotary.h + TFT_eSPI.cpp + TFT_eSPI.h + patch_init.h + Setup1_ILI9341.h+ User_Setup_Select.h

TFT_eSPI library version Created by Bodmer 2/12/16
                                      Last update by Bodmer 20/03/20
SI4735 library version date  2019-2020

1)
SI4735_2.8_TFT_V3.0:732:16: error: expected initializer before 'RotaryEncFreq'
 void IRAM_ATTR RotaryEncFreq()  {
                ^~~~~~~~~~~~~
SI4735_2.8_TFT_V3.0:732:16: error: expected initializer before 'RotaryEncFreq'
 void IRAM_ATTR RotaryEncFreq()  {
                ^~~~~~~~~~~~~

code =
void IRAM_ATTR RotaryEncFreq()  {
...
}
removing IRAM_ATTR solves this error.
what is purpost of and what means IRAM_ATTR?

2)
path\SI4735_2.8_TFT_V3.0\SI4735_2.8_TFT_V3.0.ino: In function 'void setup()':
SI4735_2.8_TFT_V3.0:781:9: error: 'class TFT_eSPI' has no member named 'setTouch'
     tft.setTouch(calData);
         ^~~~~~~~

the requested library got from https://github.com/Bodmer/TFT_eSPI + imported it...

3)

SI4735_2.8_TFT_V3.0:790:32: error: no matching function for call to 'EEPROMClass::begin(int)'
   if (!EEPROM.begin(EEPROM_SIZE))
                                ^
In file included from path\SI4735_2.8_TFT_V3.0\SI4735_2.8_TFT_V3.0.ino:68:0:
C:\Users\nn\AppData\Local\Arduino15\packages\arduino\hardware\avr\1.8.4\libraries\EEPROM\src/EEPROM.h:125:11: note: candidate: EEPtr EEPROMClass::begin()
     EEPtr begin()                        { return 0x00; }
           ^~~~~
C:\Users\nn\AppData\Local\Arduino15\packages\arduino\hardware\avr\1.8.4\libraries\EEPROM\src/EEPROM.h:125:11: note:   candidate expects 0 arguments, 1 provided
SI4735_2.8_TFT_V3.0:815:57: error: 'RotaryEncFreq' was not declared in this scope
   attachInterrupt(digitalPinToInterrupt(ENCODER_PIN_A), RotaryEncFreq, CHANGE);
                                                         ^~~~~~~~~~~~~
SI4735_2.8_TFT_V3.0:899:3: error: 'xTaskCreate' was not declared in this scope
   xTaskCreate(SaveInEeprom, "SaveInEeprom", 2048, NULL, 1, NULL);
   ^~~~~~~~~~~
path\SI4735_2.8_TFT_V3.0\SI4735_2.8_TFT_V3.0.ino: In function 'void SaveInEeprom(void*)':
SI4735_2.8_TFT_V3.0:928:12: error: 'struct EEPROMClass' has no member named 'commit'
     EEPROM.commit();
            ^~~~~~
SI4735_2.8_TFT_V3.0:930:23: error: 'portTICK_RATE_MS' was not declared in this scope
     vTaskDelay(5000 / portTICK_RATE_MS);
                       ^~~~~~~~~~~~~~~~
SI4735_2.8_TFT_V3.0:930:5: error: 'vTaskDelay' was not declared in this scope
     vTaskDelay(5000 / portTICK_RATE_MS);
     ^~~~~~~~~~
path\SI4735_2.8_TFT_V3.0\SI4735_2.8_TFT_V3.0.ino: In function 'void saveConfig()':
SI4735_2.8_TFT_V3.0:943:10: error: 'struct EEPROMClass' has no member named 'commit'
   EEPROM.commit();
          ^~~~~~
path\SI4735_2.8_TFT_V3.0\SI4735_2.8_TFT_V3.0.ino: In function 'void loop()':
SI4735_2.8_TFT_V3.0:1158:19: error: 'class TFT_eSPI' has no member named 'getTouch'; did you mean 'getColor'?
     pressed = tft.getTouch(&x, &y);
                   ^~~~~~~~
                   getColor
path\SI4735_2.8_TFT_V3.0\SI4735_2.8_TFT_V3.0.ino: In function 'void subrstatus()':
SI4735_2.8_TFT_V3.0:2315:20: error: 'class TFT_eSPI' has no member named 'getTouch'; did you mean 'getColor'?
     presStat = tft.getTouch(&x, &y);
                    ^~~~~~~~
                    getColor
Meerdere bibliotheken gevonden voor "SI4735.h"
Gebruikt: C:\Users\nn\Documents\Arduino\libraries\SI4735-master
Niet gebruikt: C:\Users\nn\Documents\Arduino\libraries\PU2CLR_SI4735
exit status 1
expected initializer before 'RotaryEncFreq'

the errors are a bit complicated so addressed as an issue.

and also is it possible to compile it and provide the bin file to load with esptool.exe?

regards Roel

pe0mgb, 2022-02-22:
Hi Roel,
You have a big problem with the libraries. Installed the ESP32 from Espressif systems in the Arduino board manager?  Then the ESP32 Dev. Module selected? In my github you can read in Readme what to do with the configuration files for the library TFT_eSPI. The TFT_eSPI library just needs to be installed in the library directory under the Arduino directory. I don't make bin files if only that some program options have to be selected in the ino.
Good luck,
Gert PE0MGB

hamroel, 2022-02-22:
the                error: 'class TFT_eSPI' has no member named 'setTouch' tft.setTouch(calData);                      has been gone:

-the directory with the ino-file contains:
patch_full.h
patch_init.h
Rotary.cpp
Rotary.h
SI4735_2.8_TFT_V3.0.ino

-the (latest) library TFT_eSPI-master.zip has been added to the libraries

-the "User_Setup_Select.h" provided with the versionpackage placed in
path\Arduino\libraries\TFT_eSPI-master

       note the path of the include in "User_Setup_Select.h" is correct:
         #include <User_Setups/Setup1_ILI9341.h>  // Setup file configured for my ILI9341  2.8 inch

-the "Setup1_ILI9341.h" provided with the versionpackage placed in
path\Arduino\libraries\TFT_eSPI-master\User_Setups overwriting the "Setup1_ILI9341.h" of the library

Roel

hamroel, 2022-02-22:
SI4735_2.8_TFT_V3.0:790:32: error: no matching function for call to 'EEPROMClass::begin(int)'
if (!EEPROM.begin(EEPROM_SIZE))

has been solved:

somehow I selected before indeed the ESP32 Dev Module at first but the LDE has selected later on the previous Anet board.

succesfully compiling is possible:

De schets gebruikt 336354 bytes (25%)  programma-opslagruimte. Maximum is 1310720 bytes.
Globale variabelen gebruiken 18120 bytes (5%) van het dynamisch geheugen. Resteren 309560 bytes voor lokale variabelen. Maximum is 327680 bytes.

Closed 2022-02-22.

Thread 16 (2022-02-27):

BIN(hex) files for ESP32 and upload tool V3.0-V3.4

hamroel, 2022-02-27:
If somebody is able to compile  an INO-file with its libraries the whole compiling-history is stored in a local temp-directory
C:\Users\nn\AppData\Local\Temp\arduino_build_400xxx
There appear also the bin files for ESP32 and when copied before IDE is closed you can use them for ESPtool.exe
For SI4735_2.8_TFT_V3.4 it will be like this:

26-03-2021  12:26            17.120 bootloader_dio_80m.bin
26-03-2021  12:26             8.192 boot_app0.bin
12-04-2021  22:22             3.519.420 esptool.exe
27-02-2022  11:38            560 flash.bat
27-02-2022  10:57            407.520 SI4735_2.8_TFT_V3.4.ino.bin
27-02-2022  10:57            3.072 SI4735_2.8_TFT_V3.4.ino.partitions.bin

If running the flash.bat (modified for SI4735_2.8_TFT_V3.4) it skips the whole compiling process and pumps it into the ESP32 WROOM

content of flash.bat:

@echo off
echo -----------------------------
echo - Update tool ESP32 SI4735  -
echo -       Version V3.4        -
echo -----------------------------
echo.
echo Available COM-ports:
chgport
echo.
set /p COM=Enter Comport number (example: 3):
esptool.exe --chip esp32 --port COM%COM% --baud 921600 --before default_reset --after hard_reset write_flash -z --flash_mode dio --flash_freq 80m --flash_size detect 0xe000 boot_app0.bin 0x1000 bootloader_dio_80m.bin 0x10000 SI4735_2.8_TFT_V3.4.ino.bin  0x8000 SI4735_2.8_TFT_V3.4.ino.partitions.bin
@pause

regards Roel

hamroel, 2022-02-27:
[SI4735_2.8_TFT_V3.4 gecompileerd.zip](https://github.com/pe0mgb/SI4735-Radio-ESP32-Touchscreen-Arduino/files/8148969/SI4735_2.8_TFT_V3.4.gecompileerd.zip)
[supporting files.zip](https://github.com/pe0mgb/SI4735-Radio-ESP32-Touchscreen-Arduino/files/8148972/supporting.files.zip)

pe0mgb, 2022-03-25:
With the zip file you can not make your own selections in the different options.

Thread 18 (2022-04-01):

Rotary Encoder Reversed in 3.5

smannchen, 2022-04-01:
I just purchased my ATS25 and it shipped with Firmware 3.1 after upgrading to 3.5 I noticed the tuning was backwards.

To resolve this issue I changed line 946 from CW to CCW and it works.

Originally
946      if (encoderStatus == DIR_CW)// Direction clockwise

Changed to
946      if (encoderStatus == DIR_CCW)// Direction counter-clockwise

jalobaugh, 2022-04-03:
Thanks for this. I've just purchased an ATS-25 and found out there was an update that included the N/S American band plans. I'm new to Arduino and this threw me for a loop. I figured this was the line to change, but wasn't sure on the syntax.

smannchen, 2022-04-03:
Glad I could help. Was my first time playing with this radio, and I was confused why it was tuning backwards after the upgrade lol.

Thread 20 (2022-05-09):

Compilation errors

Gods69, 2022-05-09:
Hi,
I got thoses compilation errors... Thanks.

Arduino : 1.8.16 (Windows 7), Carte : "ESP32 Dev Module, Disabled, Default 4MB with spiffs (1.2MB APP/1.5MB SPIFFS), 240MHz (WiFi/BT), QIO, 80MHz, 4MB (32Mb), 921600, None"

In file included from C:\Users\Gods.AMIGA\Documents\Arduino\SI473X_2.8_TFT_V3.5\SI4735_2.8_TFT_SI5351_V3.5\SI4735_2.8_TFT_SI5351_V3.5.ino:98:0:

C:\Users\Gods.AMIGA\Documents\Arduino\libraries\TFT_eSPI/TFT_eSPI.h:883:8: warning: #warning >>>>------>> TOUCH_CS pin not defined, TFT_eSPI touch functions will not be available! [-Wcpp]

       #warning >>>>------>> TOUCH_CS pin not defined, TFT_eSPI touch functions will not be available!

        ^

C:\Users\Gods.AMIGA\Documents\Arduino\SI473X_2.8_TFT_V3.5\SI4735_2.8_TFT_SI5351_V3.5\SI4735_2.8_TFT_SI5351_V3.5.ino: In function 'void setup()':

SI4735_2.8_TFT_SI5351_V3.5:989:7: error: 'class TFT_eSPI' has no member named 'setTouch'

   tft.setTouch(calData);

       ^

C:\Users\Gods.AMIGA\Documents\Arduino\SI473X_2.8_TFT_V3.5\SI4735_2.8_TFT_SI5351_V3.5\SI4735_2.8_TFT_SI5351_V3.5.ino: In function 'void loop()':

SI4735_2.8_TFT_SI5351_V3.5:1500:19: error: 'class TFT_eSPI' has no member named 'getTouch'

     pressed = tft.getTouch(&x, &y);

                   ^

C:\Users\Gods.AMIGA\Documents\Arduino\SI473X_2.8_TFT_V3.5\SI4735_2.8_TFT_SI5351_V3.5\SI4735_2.8_TFT_SI5351_V3.5.ino: In function 'void subrstatus()':

SI4735_2.8_TFT_SI5351_V3.5:2989:20: error: 'class TFT_eSPI' has no member named 'getTouch'

     presStat = tft.getTouch(&x, &y);

                    ^

C:\Users\Gods.AMIGA\Documents\Arduino\SI473X_2.8_TFT_V3.5\SI4735_2.8_TFT_SI5351_V3.5\SI4735_2.8_TFT_SI5351_V3.5.ino: In function 'bool checkStopSeeking()':

SI4735_2.8_TFT_SI5351_V3.5:3150:37: error: 'class TFT_eSPI' has no member named 'getTouch'

   return (bool) encoderCount || tft.getTouch(&x, &y);   // returns true if the user rotates the encoder or touches on screen

                                     ^

C:\Users\Gods.AMIGA\Documents\Arduino\SI473X_2.8_TFT_V3.5\SI4735_2.8_TFT_SI5351_V3.5\SI4735_2.8_TFT_SI5351_V3.5.ino: In function 'void showFirmwareInformation()':

SI4735_2.8_TFT_SI5351_V3.5:3366:20: error: 'class TFT_eSPI' has no member named 'getTouch'

     presStat = tft.getTouch(&x, &y);

                    ^

exit status 1

'class TFT_eSPI' has no member named 'setTouch'

jalobaugh, 2022-05-09:
Did you update the Arduino libraries prior to compiling?

This line is in the readme and it's an important one:

Move the file Setup1_ILI9341.h to the root or top directory of the TFT_eSPI library. Replace the file User_Setup_Select.h in same directory by the file User_Setup_Select.h in my github. The compiler runs after that smoothly.

Closed 2022-05-11.

Thread 21 (2022-06-05):

Compile Error

ESSCHENK1, 2022-06-05:
Hello,

I have an error while compiling version3.5
version 3.4 is working nice.

There whas no adc.h file in the zip.
so i found something online and use that.

Thanks in advanced.
Ed PA1TR

This is the error i get.

Arduino:1.8.13 (Windows 10), Board:"ESP32-WROOM-DA Module, Default 4MB with spiffs (1.2MB APP/1.5MB SPIFFS), 240MHz (WiFi/BT), QIO, 80MHz, 4MB (32Mb), 921600, Core 1, Core 1, None"

C:\arduino\examples\SI473X_2.8_TFT_V3.5\SI4735_2.8_TFT_SI5351_V3.5\SI4735_2.8_TFT_SI5351_V3.5.ino: In function 'uint32_t readADC_Cal(int)':
SI4735_2.8_TFT_SI5351_V3.5:3440:3: error: 'esp_adc_cal_characteristics_t' was not declared in this scope
   esp_adc_cal_characteristics_t adc_chars;
   ^~~~~~~~~~~~~~~~~~~~~~~~~~~~~
SI4735_2.8_TFT_SI5351_V3.5:3442:28: error: 'ADC_UNIT_1' was not declared in this scope
   esp_adc_cal_characterize(ADC_UNIT_1, ADC_ATTEN_DB_11, ADC_WIDTH_BIT_12, 1100, &adc_chars);

                            ^~~~~~~~~~

SI4735_2.8_TFT_SI5351_V3.5:3442:40: error: 'ADC_ATTEN_DB_11' was not declared in this scope

   esp_adc_cal_characterize(ADC_UNIT_1, ADC_ATTEN_DB_11, ADC_WIDTH_BIT_12, 1100, &adc_chars);

                                        ^~~~~~~~~~~~~~~

C:\arduino\examples\SI473X_2.8_TFT_V3.5\SI4735_2.8_TFT_SI5351_V3.5\SI4735_2.8_TFT_SI5351_V3.5.ino:3442:40: note: suggested alternative: 'ADC_ATTENDB_MAX'

   esp_adc_cal_characterize(ADC_UNIT_1, ADC_ATTEN_DB_11, ADC_WIDTH_BIT_12, 1100, &adc_chars);

                                        ^~~~~~~~~~~~~~~

                                        ADC_ATTENDB_MAX

SI4735_2.8_TFT_SI5351_V3.5:3442:57: error: 'ADC_WIDTH_BIT_12' was not declared in this scope

   esp_adc_cal_characterize(ADC_UNIT_1, ADC_ATTEN_DB_11, ADC_WIDTH_BIT_12, 1100, &adc_chars);

                                                         ^~~~~~~~~~~~~~~~

SI4735_2.8_TFT_SI5351_V3.5:3442:82: error: 'adc_chars' was not declared in this scope

   esp_adc_cal_characterize(ADC_UNIT_1, ADC_ATTEN_DB_11, ADC_WIDTH_BIT_12, 1100, &adc_chars);

                                                                                  ^~~~~~~~~

C:\arduino\examples\SI473X_2.8_TFT_V3.5\SI4735_2.8_TFT_SI5351_V3.5\SI4735_2.8_TFT_SI5351_V3.5.ino:3442:82: note: suggested alternative: 'u_char'

   esp_adc_cal_characterize(ADC_UNIT_1, ADC_ATTEN_DB_11, ADC_WIDTH_BIT_12, 1100, &adc_chars);

                                                                                  ^~~~~~~~~

                                                                                  u_char

SI4735_2.8_TFT_SI5351_V3.5:3442:3: error: 'esp_adc_cal_characterize' was not declared in this scope

   esp_adc_cal_characterize(ADC_UNIT_1, ADC_ATTEN_DB_11, ADC_WIDTH_BIT_12, 1100, &adc_chars);

   ^~~~~~~~~~~~~~~~~~~~~~~~

SI4735_2.8_TFT_SI5351_V3.5:3443:11: error: 'esp_adc_cal_raw_to_voltage' was not declared in this scope

   return (esp_adc_cal_raw_to_voltage(ADC_Raw, &adc_chars));

           ^~~~~~~~~~~~~~~~~~~~~~~~~~

pe0mgb, 2022-06-05:
This is a part of the ESP32 in board manager. Install the latest version and the problem is solved.Outlook voor Android downloaden

ESSCHENK1, 2022-06-06:
Thanks Gert its working perfect now.
Thanks for al the nice work.
73 Ed

Thread 22 (2022-07-03):

GERBER PCB

pashkaboss, 2022-07-03:
Help! I need GERBER PCB files for Gerber project pe0mgb SI4735-Radio-ESP32-Touch Screen-Arduino. Where can I find them?

husseinalijaafar, 2023-01-31:
Were you able to find the Gerber files?

z34pec, 2024-09-09:
Soon be able to have them. In test phase if you still need it ?

n-connect, 2024-10-26:
Yes please

Thread 23 (2023-03-17):

TFT rotate

FabioLucca01, 2023-03-17:
I assembled the standard circuit, the same as the project (ILI9341 + ESP32WROOM32 + Si4735), however the display is not in the correct rotation, both vertically and horizontally it does not draw all the buttons, and the position of the buttons is always incorrect in relation to screen, I already messed with the configuration in many points of the code without success. I'm using the updated libraries, is there a problem related to the new library? Has anyone ever experienced this?
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

pe0mgb, 2023-03-17:
Hello Fabio,It is a pitty that you are facing some problems. Let me try to help you.What is the size of the screen? Can you send me a picture of the screen with the original sketch?Greetings.Gert PE0MGBOp 17 mrt. 2023 21:12 schreef FabioLucca01 ***@***.***>:
I assembled the standard circuit, the same as the project (ILI9341 + ESP32WROOM32 + Si4735), however the display is not in the correct rotation, both vertically and horizontally it does not draw all the buttons, and the position of the buttons is always incorrect in relation to screen, I already messed with the configuration in many points of the code without success. I'm using the updated libraries, is there a problem related to the new library? Has anyone ever experienced this?

—Reply to this email directly, view it on GitHub, or unsubscribe.You are receiving this because you are subscribed to this thread.Message ID: ***@***.***>

FabioLucca01, 2023-03-17:
>

Hello, thanks for replying. Screen is standard 2.8" 320x240 ILI9341. I used version 3.5 of the project as per repository and replaced the 2 configuration files in the TFT library.

pe0mgb, 2023-03-19:
Fabio,

I just have checked V3.5 with the latest version of TFT_eSPI and I didn’t find any problem.

When I look at the picture of the screen you have send, colors and size are wrong. This is related to a problem in configuration of the library software. Not related with the V3.5 radio ino.

Can you send me a picture of the backside of the TFT screen?

Regards,

Gert PE0MGB

Van: FabioLucca01 ***@***.***>
Verzonden: zaterdag 18 maart 2023 00:35
Aan: pe0mgb/SI4735-Radio-ESP32-Touchscreen-Arduino ***@***.***>
CC: Gert PE0MGB ***@***.***>; Comment ***@***.***>
Onderwerp: Re: [pe0mgb/SI4735-Radio-ESP32-Touchscreen-Arduino] TFT rotate (Issue #23)

Hello, thanks for replying. Screen is standard 2.8" 320x240 ILI9341. I used version 3.5 of the project as per repository and replaced the 2 configuration files in the TFT library.

—
Reply to this email directly, view it on GitHub <https://github.com/pe0mgb/SI4735-Radio-ESP32-Touchscreen-Arduino/issues/23#issuecomment-1474514189> , or unsubscribe <https://github.com/notifications/unsubscribe-auth/AEVBG5OHOKDBVDUERKCLM6DW4TYJVANCNFSM6AAAAAAV66M57Y> .
You are receiving this because you commented.  <https://github.com/notifications/beacon/AEVBG5P3REY5ASUHVLEN3PLW4TYJVA5CNFSM6AAAAAAV66M572WGG33NNVSW45C7OR4XAZNMJFZXG5LFINXW23LFNZ2KUY3PNVWWK3TUL5UWJTSX4NGQ2.gif> Message ID: ***@***.*** ***@***.***> >

pe0mgb, 2023-03-19:
//#include <Setup3_ILI9488.h>       // Setup file configured for my ILI9488  3.5 inch

#include <Setup1_ILI9341.h>         // Setup file configured for my ILI9341  2.8 inch  esp32       <=============================================

//#include <Setup4_ILI9341_8266.h>  // Setup file configured for my ILI9341  2.8 inch  8266

//#include <Setup2_ST7735.h>        // Setup file configured for my ST7735

Is line 27 in the User_Setup_Select file like above

Van: FabioLucca01 ***@***.***>
Verzonden: zaterdag 18 maart 2023 00:35
Aan: pe0mgb/SI4735-Radio-ESP32-Touchscreen-Arduino ***@***.***>
CC: Gert PE0MGB ***@***.***>; Comment ***@***.***>
Onderwerp: Re: [pe0mgb/SI4735-Radio-ESP32-Touchscreen-Arduino] TFT rotate (Issue #23)

Hello, thanks for replying. Screen is standard 2.8" 320x240 ILI9341. I used version 3.5 of the project as per repository and replaced the 2 configuration files in the TFT library.

—
Reply to this email directly, view it on GitHub <https://github.com/pe0mgb/SI4735-Radio-ESP32-Touchscreen-Arduino/issues/23#issuecomment-1474514189> , or unsubscribe <https://github.com/notifications/unsubscribe-auth/AEVBG5OHOKDBVDUERKCLM6DW4TYJVANCNFSM6AAAAAAV66M57Y> .
You are receiving this because you commented.  <https://github.com/notifications/beacon/AEVBG5P3REY5ASUHVLEN3PLW4TYJVA5CNFSM6AAAAAAV66M572WGG33NNVSW45C7OR4XAZNMJFZXG5LFINXW23LFNZ2KUY3PNVWWK3TUL5UWJTSX4NGQ2.gif> Message ID: ***@***.*** ***@***.***> >

FabioLucca01, 2023-03-19:
Hi, my "User_Setup_Select" is correct like yours above:
#include <Setup1_ILI9341.h> // Setup file configured for my ILI9341 2.8 inch esp32

The ".ino" sketck is correct, I used a standard example from the TFT_eSPI library and the display doesn't work right, always cutting off some part of the screen, I will study the library configuration files and make some changes to see if it fixes it, if I find it the solution I return here. Thanks for the help.
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

pe0mgb, 2023-03-19:
Fabio,
An other common failure is to have more installations of TFT_eSPI library. Check that. And take a look at the link-list of the IDE compiling process. There you can see which library is used in the linking proces.

Verzonden vanuit Mail voor Windows

Van: FabioLucca01
Verzonden: zondag 19 maart 2023 19:06
Aan: pe0mgb/SI4735-Radio-ESP32-Touchscreen-Arduino
CC: Gert PE0MGB; Comment
Onderwerp: Re: [pe0mgb/SI4735-Radio-ESP32-Touchscreen-Arduino] TFT rotate (Issue#23)

Hi, my "User_Setup_Select" is correct like yours above:
#include <Setup1_ILI9341.h> // Setup file configured for my ILI9341 2.8 inch esp32
The ".ino" sketck is correct, I used a standard example from the TFT_eSPI library and the display doesn't work right, always cutting off some part of the screen, I will study the library configuration files and make some changes to see if it fixes it, if I find it the solution I return here. Thanks for the help.

—
Reply to this email directly, view it on GitHub, or unsubscribe.
You are receiving this because you commented.Message ID: ***@***.***>

FabioLucca01, 2023-03-21:
Hello, I managed to make it work just by changing 3 lines of code in the .ino . One in the constructor forcing it to the dimensions of the screen (320x240) and the others were referring to the orientation (rotate(2)) and the touch that was changed. Attached image with changed lines.
It's certainly not the most elegant way to solve it, but that's how I managed it.

Grateful.

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

pe0mgb, 2023-03-21:
Good to hear that it is working. Still confused about your solution and why. There are already hundreds of radios build whitout any problem. But anyway it works. Did you changed the color of the buttons etc.All colors are different.Op 21 mrt. 2023 13:52 schreef FabioLucca01 ***@***.***>:
Hello, I managed to make it work just by changing 3 lines of code in the .ino . One in the constructor forcing it to the dimensions of the screen (320x240) and the others were referring to the orientation (rotate(2)) and the touch that was changed. Attached image with changed lines.
It's certainly not the most elegant way to solve it, but that's how I managed it.
Grateful.

—Reply to this email directly, view it on GitHub, or unsubscribe.You are receiving this because you commented.Message ID: ***@***.***>

FabioLucca01, 2023-03-21:
Hi, I only changed 3 lines of code from the .ino that are in the above comment image.
My libraries are up to date and I recently downloaded all of them. If the colors are different, it wasn't me who changed it, so I suspect that this display is a clone or not an ILI9341 and therefore has some differences... but it ended up working. Now I'm going to work on the RF part, I'm waiting for the Si5351 to arrive.

Once again thanks for the support.

pe0mgb, 2023-03-21:
Clear, thanks.Op 21 mrt. 2023 23:21 schreef FabioLucca01 ***@***.***>:
Hi, I only changed 3 lines of code from the .ino that are in the above comment image.
My libraries are up to date and I recently downloaded all of them. If the colors are different, it wasn't me who changed it, so I suspect that this display is a clone or not an ILI9341 and therefore has some differences... but it ended up working. Now I'm going to work on the RF part, I'm waiting for the Si5351 to arrive.
Once again thanks for the support.

—Reply to this email directly, view it on GitHub, or unsubscribe.You are receiving this because you commented.Message ID: ***@***.***>

Thread 24 (2023-06-13):

Compilation error: 'class TFT_eSPI' has no member named 'setTouch'

andreasmon, 2023-06-13:
Hello,
 i try to verify code form here https://github.com/pe0mgb/SI4735-Radio-ESP32-Touchscreen-Arduino
doit devkit v1 with tft 240x320 2.8" SPI TFT LCD Touch Panel Serial Port Module With PBC ILI9341.

i run version SI473X_2.8_TFT_V3.3  

I get errors but fix enough.
Now i get error :

error: 'class TFT_eSPI' has no member named 'setTouch'

i try many ,but nothing fix it.

Any help;
Thank you.

andreasmon, 2023-06-13:
First time try verify the code, i fix some errors by add  thef ollow lines in code:

#include <Adafruit_GFX.h>
 #define TFT_CS 15

pe0mgb, 2023-06-14:
First of all there are no errors in the code. Many V3.3 programs work to complete satisfaction. V3.5 has more significant improvements in operation and presentation. First remove all added include and defines. They only cause more misery.

Start by reading the readme file on the opening page of the SI4735 in my GitHub. Copy the file Setup1_ILI9341.h to the root directory of TFT_eSPI library and replace the User_Setup_Select.h file in the same root directory. Make sure you have the latest version of this library installed.

Now the mentioned compiler errors will be a thing of the past.

Greeting,

Gert

Van: andreasmon ***@***.***>
Verzonden: dinsdag 13 juni 2023 22:23
Aan: pe0mgb/SI4735-Radio-ESP32-Touchscreen-Arduino ***@***.***>
CC: Subscribed ***@***.***>
Onderwerp: Re: [pe0mgb/SI4735-Radio-ESP32-Touchscreen-Arduino] Compilation error: 'class TFT_eSPI' has no member named 'setTouch' (Issue #24)

First time try verify the code, i fix some errors by add thef ollow lines in code:

#include <Adafruit_GFX.h>
#define TFT_CS 15

—
Reply to this email directly, view it on GitHub <https://github.com/pe0mgb/SI4735-Radio-ESP32-Touchscreen-Arduino/issues/24#issuecomment-1589971680> , or unsubscribe <https://github.com/notifications/unsubscribe-auth/AEVBG5KHJWRVEESWUI3AQJLXLDD3DANCNFSM6AAAAAAZFMPBEQ> .
You are receiving this because you are subscribed to this thread.Message ID: ***@***.***>

andreasmon, 2023-06-14:
Hello.thank you for your time and your answer.

I have 7 days trying compile the code.I have read the readme file and do things you write about.
I also have install last version  2.0.9  of esp32 by espressif systems.

i delete libraries and files and start again to compile the code of version 3.3,but i get error again.
I try it to another computer that i install arduino ide for first time and same error again.

Last i  record a video for this , installed the libraries and try to compile the code .I upload it to youtube .Its free to watch.

Can you, when you have time watch the video and  find what i am doing wrong; Or maybe my english not help me understand correct what i must do .

link for free watch youtube video of error:

https://www.youtube.com/watch?v=I0TgrD7qIwc

Thank you again.

pe0mgb, 2023-06-14:
Maybe you have installed the TFT_eSPI lib. twice.Op 14 jun. 2023 22:50 schreef andreasmon ***@***.***>:
Hello.thank you for your time and your answer.
I have 7 days trying compile the code.I have read the readme file and do things you write about.
I also have install last version  2.0.9  of esp32 by espressif systems.
i delete libraries and files and start again to compile the code of version 3.3,but i get error again.
I try it to another computer that i install arduino ide for first time and same error again.
Last i  record a video for this , installed the libraries and try to compile the code .I upload it to youtube .Its free to watch.
Can you, when you have time watch the video and  find what i am doing wrong; Or maybe my english not help me understand correct what i must do .
link for free watch youtube video of error:
https://www.youtube.com/watch?v=I0TgrD7qIwc
Thank you again.

—Reply to this email directly, view it on GitHub, or unsubscribe.You are receiving this because you commented.Message ID: ***@***.***>

pe0mgb, 2023-06-14:
I'm traveling at the moment . I will react in the coming weekend.Op 14 jun. 2023 23:54 schreef Gert Baak ***@***.***>:Maybe you have installed the TFT_eSPI lib. twice.Op 14 jun. 2023 22:50 schreef andreasmon ***@***.***>:
Hello.thank you for your time and your answer.
I have 7 days trying compile the code.I have read the readme file and do things you write about.
I also have install last version  2.0.9  of esp32 by espressif systems.
i delete libraries and files and start again to compile the code of version 3.3,but i get error again.
I try it to another computer that i install arduino ide for first time and same error again.
Last i  record a video for this , installed the libraries and try to compile the code .I upload it to youtube .Its free to watch.
Can you, when you have time watch the video and  find what i am doing wrong; Or maybe my english not help me understand correct what i must do .
link for free watch youtube video of error:
https://www.youtube.com/watch?v=I0TgrD7qIwc
Thank you again.

—Reply to this email directly, view it on GitHub, or unsubscribe.You are receiving this because you commented.Message ID: ***@***.***>

andreasmon, 2023-07-02:
hello,

did we have any news;

thank you.

pe0mgb, 2023-07-05:
Hello,

Sorry for long delay but I'm traveling and not always in contact with a
network.

I have tried to follow your youtube info.

Not always easy but anyway. I think that I have seen that in the top
directory of TFT_eSPI library the wrong files are installed, checking the
date.

Please install my two files from github in the top directory from TFT_eSPI.

The no touch compiler error is caused because the touch info is missing in
the default setup1_ ILI9341.h file. My files solve that problem.

Hope this will work.

Success

Van: andreasmon ***@***.***>
Verzonden: zondag 2 juli 2023 17:05
Aan: pe0mgb/SI4735-Radio-ESP32-Touchscreen-Arduino
***@***.***>
CC: Gert PE0MGB ***@***.***>; Comment ***@***.***>
Onderwerp: Re: [pe0mgb/SI4735-Radio-ESP32-Touchscreen-Arduino] Compilation
error: 'class TFT_eSPI' has no member named 'setTouch' (Issue #24)

hello,

did we have any news;

thank you.

-
Reply to this email directly, view it on GitHub
<https://github.com/pe0mgb/SI4735-Radio-ESP32-Touchscreen-Arduino/issues/24#
issuecomment-1616690583> , or unsubscribe
<https://github.com/notifications/unsubscribe-auth/AEVBG5L4KSMRH3765XY774LXO
GD2DANCNFSM6AAAAAAZFMPBEQ> .
You are receiving this because you commented.Message ID:
***@***.***
om>

andreasmon, 2023-07-06:
thank you for your help and also understand that you are working...So no problem for the delay.

I do not understand who files of the library,i must replace .If you check it and working can you send me the working .ino file aarduino code  or also and the correct library;

Thank you.

andreasmon, 2023-09-15:
hello,i finnaly solve the problem and upload code.I upload version 3.3

Now touch screen ILI4931 show the above message:

SI4735/32 RADIO
VERSION 3.3
02-11-2021
SI4735 not detected

and program stop,freeze there...

in my circuit i have used sis4732 ic,and no the  4735.

i upload also version 3.5,but same again

Thread 25 (2023-12-23):

SI5351 not found

dpechman, 2023-12-23:
I have tryed SI4735_2.8_TFT_SI5351_V3.5 with crystal and it runs nice.

Have then tried to use si5351 enabling it on:

//#define IhaveCrystal
#define IhaveSI5351

but its returning SI5351 not found and its not generating any frequency on output.

How to debug it?

dpechman, 2023-12-23:
I did a test inverting data and clock (on pink board) and it starts without msg of **SI5351 not found** and generate a frequency about 42MHZ on output, but frequency generated not change at all.

Using the right pins the output is dead.

73

pe0mgb, 2023-12-24:
Daniel,

Hereby a picture how the si5351 is connected to the radio. When it is not running it is hard to find out by me what’s going wrong. The software is OK and in use by many many people.

Do you have placed the jumper, left of the coil at the picture, in the right position?

When you still have problems please let me know.

Best regards,

Gert PE0MGB

Van: Daniel Pechmann ***@***.***>
Verzonden: zaterdag 23 december 2023 18:15
Aan: pe0mgb/SI4735-Radio-ESP32-Touchscreen-Arduino ***@***.***>
CC: Subscribed ***@***.***>
Onderwerp: Re: [pe0mgb/SI4735-Radio-ESP32-Touchscreen-Arduino] SI5351 not found (Issue #25)

I did a test inverting data and clock (on pink board) and it starts without msg of SI5351 not found and generate a frequency about 42MHZ on output, but frequency generated not change at all.

Using the right pins the output is dead.

73

—
Reply to this email directly, view it on GitHub <https://github.com/pe0mgb/SI4735-Radio-ESP32-Touchscreen-Arduino/issues/25#issuecomment-1868334243> , or unsubscribe <https://github.com/notifications/unsubscribe-auth/AEVBG5NBQMSMIRGOO6IT2FTYK4GSNAVCNFSM6AAAAABBA5CNIGVHI2DSMVQWIX3LMV43OSLTON2WKQ3PNVWWK3TUHMYTQNRYGMZTIMRUGM> .
You are receiving this because you are subscribed to this thread.  <https://github.com/notifications/beacon/AEVBG5MLTKVKAE43EKF4W2DYK4GSNA5CNFSM6AAAAABBA5CNIGWGG33NNVSW45C7OR4XAZNMJFZXG5LFINXW23LFNZ2KUY3PNVWWK3TUL5UWJTTPLSCKG.gif> Message ID: ***@***.*** ***@***.***> >

Thread 26 (2024-01-23):

Compilation error: 'But_Key_Width' was not declared in this scope

JKorvo, 2024-01-23:
Hi, when i try to compile the code on arduino IDE i found this error and not compile! Any ideas? I try a older version and the last version of arduino IDE. The libraries is correct and i don´t know why this happens. Can you help?
Thank you.

pe0mgb, 2024-01-24:
Which version of the program are you compiling? V3-???

Van: JKorvo ***@***.***>
Verzonden: dinsdag 23 januari 2024 20:27
Aan: pe0mgb/SI4735-Radio-ESP32-Touchscreen-Arduino ***@***.***>
CC: Subscribed ***@***.***>
Onderwerp: [pe0mgb/SI4735-Radio-ESP32-Touchscreen-Arduino] Compilation error: 'But_Key_Width' was not declared in this scope (Issue #26)

Hi, when i try to compile the code on arduino IDE i found this error and not compile! Any ideas? I try a older version and the last version of arduino IDE. The libraries is correct and i don´t know why this happens. Can you help?
Thank you.

—
Reply to this email directly, view it on GitHub <https://github.com/pe0mgb/SI4735-Radio-ESP32-Touchscreen-Arduino/issues/26> , or unsubscribe <https://github.com/notifications/unsubscribe-auth/AEVBG5LGXSLRZCPIDQD6WKLYQAFIFAVCNFSM6AAAAABCHRSRTOVHI2DSMVQWIX3LMV43ASLTON2WKOZSGA4TMOBTGM2DOOA> .
You are receiving this because you are subscribed to this thread.Message ID: ***@***.***>

JKorvo, 2024-01-24:
hi, thanks for your reply, i try to compile the version 3.5

Thread 27 (2024-09-08):

ledcSetup error ?

z34pec, 2024-09-08:
Hello.
I am trying to compile latest 3.5 version (my ESP 32 is found as Lilygo T-display).
When compiling I receive this error: Compilation error: 'ledcSetup' was not declared in this scope

Above this error I see where it exist:

'ledcSetup' was not declared in this scope
 968 |   ledcSetup(LedChannelforTFT, LedFreq, LedResol);
'ledcAttachPin' was not declared in this scope; did you mean 'ledcAttach'?
969 |   ledcAttachPin(Display_Led, LedChannelforTFT);

How to solve this problem ?

73 de Z34PEC

z34pec, 2024-09-08:
I also tried all of given versions. Also copied suggested files to required TFT_Espi library (one in root of the library and the second in Users_Setup folder). Still receive thess ledcSetup erro while trying to verify your sketch. Where I go wrong I do not know, I lost  a day trying to figure out what is the error.
Here is screenshot of error.
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

z34pec, 2024-09-08:
OK, looks like I find the cause of this error.
At thismoment latest update version of ESP 32 boards from espressif is 3.0.4 and error exist in every version that start with 3.x
With 2.0.17 there is no error but no communication is make with esp32.
Looks like there should be update of sketch to work with newest esp32 boards updates.

garrysblog, 2025-04-23:
In the ESP32 v3 core ledcSetup and ledcAttachPin have been merged into the single command ledcAttach. I changed these lines in SI4735_2.8_TFT_SI5351_V3.5.ino from this:

```
ledcSetup(LedChannelforTFT, LedFreq, LedResol);
ledcAttachPin(Display_Led, LedChannelforTFT);
```

To this:

`ledcAttach(LedChannelforTFT, LedFreq, LedResol);`

The sketch compiles and uploaded without errors and appears to be running correctly. However, I'm not particularly familiar with all the features of this radio so am not 100% sure there are no other side effects of using the v3 core.

There is more about the ledcAttach change here [https://docs.espressif.com/projects/arduino-esp32/en/latest/migration_guides/2.x_to_3.0.html#ledc](https://docs.espressif.com/projects/arduino-esp32/en/latest/migration_guides/2.x_to_3.0.html#ledc)

I am using Arduino IDE v2.3.6 and v3.2.0 of the esp32 board core library

Thread 28 (2024-10-24):

Using 2.4" TFT touch with ILI9341 - SETUP calibration of horizontal position

z34pec, 2024-10-24:
Well I had a couple of days issue with implementing 2.4" 240x320 touch screen instead of 2.8" .
I was told that nothing needs to be changed and that it could work good. Unfortunately there is displacement of touch points on the screen on 2.4" so as a final result you will face problem with selecting given menus with a touch. Coordinates of menus on screen and touch points just do not match.
So there is a need to use calibration sketch so you could have proper settings for your display.
This is a situation for horizontal screen, vertical and 180 degrees rotated I do not know how to get proper calibration.
So, if PE0MGB is willing to add this sketch to it's setup and do some doc update ?

In order to proper calibrate,  of tft display are:
#define TFT_MISO 19
#define TFT_MOSI 23
#define TFT_SCLK 18
#define TFT_CS   15  // Chip select control pin
#define TFT_DC    2  // Data Command control pin
#define TFT_RST   4
#define TOUCH_CLK 18 //
#define TOUCH_CS 21 //  Chip select pin (T_CS) of touch screen
#define TOUCH_DIN 23 //
#define TOUCH_DO 19 ///

[Touch_Controller_Demo_ILI9341_Touch_screen.zip](https://github.com/user-attachments/files/17502263/Touch_Controller_Demo_ILI9341_Touch_screen.zip)

Thread 29 (2024-12-03):

Error Compilation

cabralcr, 2024-12-03:
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

Hello, I'm trying to compile version 3.5 and this error is appearing, and all the files are in the same directory and I've already replaced the file in the main library, could anyone help me?

ta3lg, 2025-01-05:
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
Merabalar, derleme atası bende de var.Gidermeye alışıyoruz. Bu sorunları giderebilen varsa yardımcı olmalarını bekliyoruz. Teşekkür  ederim.TA3LG/Ramazan Turkey

RecepAGulec, 2025-01-18:
Hâlâ derleme problemi devam ediyorsa, Arduino IDE'de ESP32 kartının sürümünü kontrol et. Eski 2.0.17 sürümü ile değiştir.

Thread 30 (2025-05-06):

TFT orientation

Kamayani02, 2025-05-06:
i am trying to connect a ILI9341 ( without touch ) to a ESP32WROOM32 using the adafruitGFX and Adafruit_ILI9341 libraries. however the display is not in the correct rotation, both vertically and horizontally it does not discover the whole screen and the orientation is always incorrect in relation to screen. I've added an image for better clarity on the issue. Does anyone have any idea how to solve this?

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
