pe0mgb/SI4735-Radio-ESP32-Touchscreen-Arduino/SI473X_2.8_TFT_V3.5/Button.h

// 80X40-BLACK.png
// https://lang-ship.com/tools/image2data/

const uint16_t But_Width = 80;
const uint16_t But_Height = 40;

const uint16_t But_BlackWidth = 80;
const uint16_t But_BlackHeight = 40;

// RGB565 Dump(little endian)
const unsigned short But_Black[3200] PROGMEM = {
0x0000,0x0000,0x0000,0x0000,0x0000,0x0000,0x0000,0x0000,0x0000,0x0000,0x0000,0x0000,0x0000,0x0000,0x0000,0x0000,0x0000,0x0000,0x0000,0x0000,0x0000,0x0000,0x0000,0x0000,0x0000,0x0000,0x0000,0x0000,0x0000,0x0000,0x0000,0x0000,0x0000,0x0000,0x0000,0x0000,0x0000,0x0000,0x0000,0x0000,0x0000,0x0000,0x0000,0x0000,0x0000,0x0000,0x0000,0x0000,0x0000,0x0000,0x0000,0x0000,0x0000,0x0000,0x0000,0x0000,0x0000,0x0000,0x0000,0x0000,0x0000,0x0000,0x0000,0x0000,0x0000,0x0000,0x0000,0x0000,0x0000,0x0000,0x0000,0x0000,0x0000,0x0000,0x0000,0x0000,0x0000,0x0000,0x0000,0x0000,// row 0, 80 pixels
0x0000,0x0000,0x0000,0x0000,0x0000,0x0000,0x0000,0x0000,0x0000,0x0000,0x0000,0x0000,0x0000,0x0000,0x0000,0x0000,0x0000,0x0000,0x0000,0x0000,0x0000,0x0000,0x0000,0x0000,0x0000,0x0000,0x0000,0x0000,0x0000,0x0000,0x0000,0x0000,0x0000,0x0000,0x0000,0x0000,0x0000,0x0000,0x0000,0x0000,0x0000,0x0000,0x0000,0x0000,0x0000,0x0000,0x0000,0x0000,0x0000,0x0000,0x0000,0x0000,0x0000,0x0000,0x0000,0x0000,0x0000,0x0000,0x0000,0x0000,0x0000,0x0000,0x0000,0x0000,0x0000,0x0000,0x0000,0x0000,0x0000,0x0000,0x0000,0x0000,0x0000,0x0000,0x0000,0x0000,0x0000,0x0000,0x0000,0x0000,// row 1, 160 pixels
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
0x0000,0x0000,0x0000,0x2008,0x2008,0x4129,0x8239,0x8239,0x8239,0x8239,0x8231,0x8231,0x8231,0x8231,0x8231,0x8231,0x8231,0x8231,0x8231,0x8231,0x8231,0x8231,0x8231,0x8231,0x8231,0x8231,0x8231,0x8231,0x8231,0x8231,0x8231,0x8231,0x8231,0x8231,0x8231,0x8231,0x8231,0x8231,0x8231,0x8231,0x8231,0x8231,0x8231,0x8231,0x8231,0x8231,0x8231,0x8231,0x8231,0x8231,0x8231,0x8231,0x8231,0x8231,0x8231,0x8231,0x8231,0x8231,0x8231,0x8231,0x8231,0x8231,0x8231,0x8231,0x8231,0x8231,0x8231,0x8231,0x8231,0x8231,0x8231,0x8231,0x8239,0x8239,0x4129,0x4008,0x4008,0x0000,0x0000,0x0000,// row 39, 3200 pixels
};


// 90x23bttn-1.png
// https://lang-ship.com/tools/image2data/

const uint16_t But_Mode_Width = 90;
const uint16_t But_Mode_Height = 23;

const uint16_t But_Mode_BlueWidth = 90;
const uint16_t But_Mode_BlueHeight = 23;
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
