pe0mgb/SI4735-Radio-ESP32-Touchscreen-Arduino/SI473X_2.8_TFT_V3.5/Rotary.h

// Rotary encoder library for Arduino.
#include "Arduino.h"

#ifndef rotary_h
#define rotary_h

// Enable this to emit codes twice per step
// #define HALF_STEP

#define ENABLE_PULLUPS  // Enable weak pullups

// Values returned by 'process'
#define DIR_NONE 0x0    // No complete step yet
#define DIR_CW   0x10   // Clockwise step
#define DIR_CCW  0x20   // Anti-clockwise step

class Rotary
{
  public:
    Rotary(char, char);
    // Process pin(s)
    unsigned char process();
  private:
    unsigned char state;
    unsigned char pin1;
    unsigned char pin2;
};
#endif
